sieraczynski-lab/Soloist-KT88/docs/img/plytka_glosniki.png

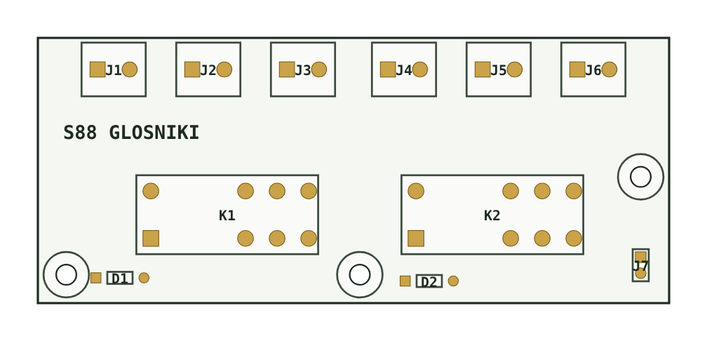
docs/img/plytka_glosniki.png
