sieraczynski-lab/Soloist-KT88/docs/img/plytka_sterowanie.png

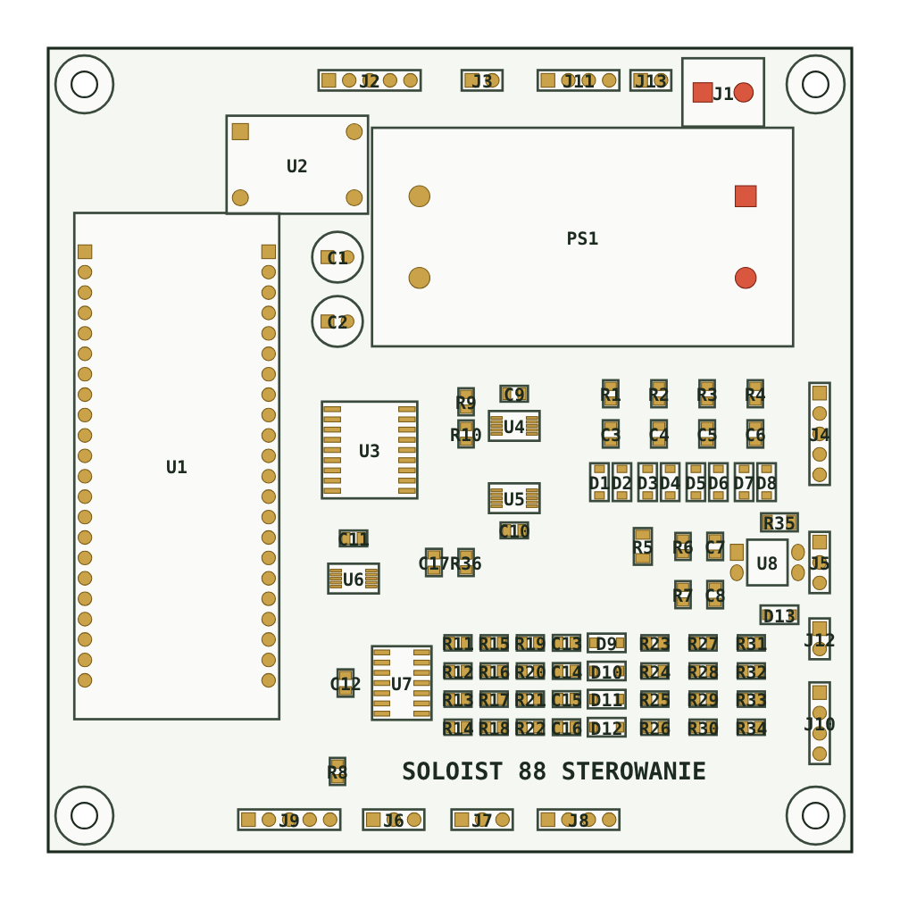
docs/img/plytka_sterowanie.png
