sieraczynski-lab/Soloist-KT88/docs/img/plytka_ul.png

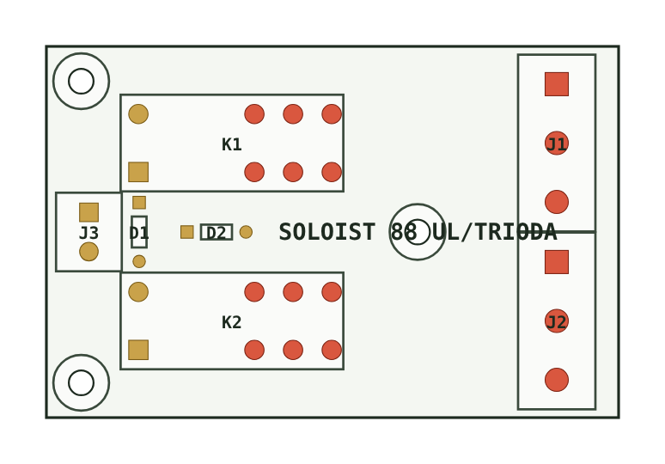
docs/img/plytka_ul.png
