sieraczynski-lab/Soloist-KT88/docs/img/plytka_zasilacz_hv.png

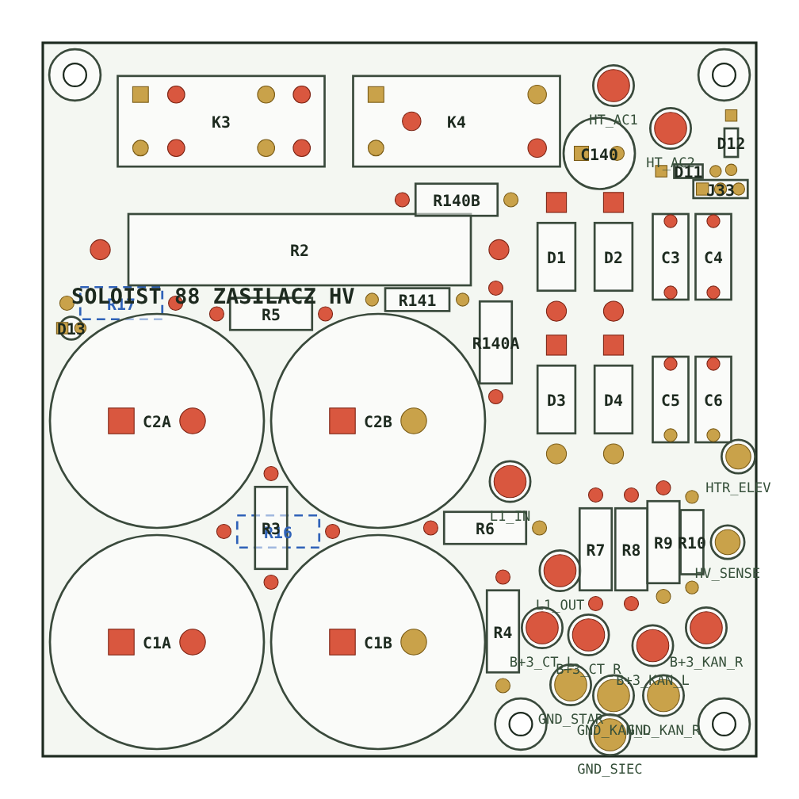
docs/img/plytka_zasilacz_hv.png
