sieraczynski-lab/Soloist-KT88/docs/img/plytka_zasilacz_siec.png

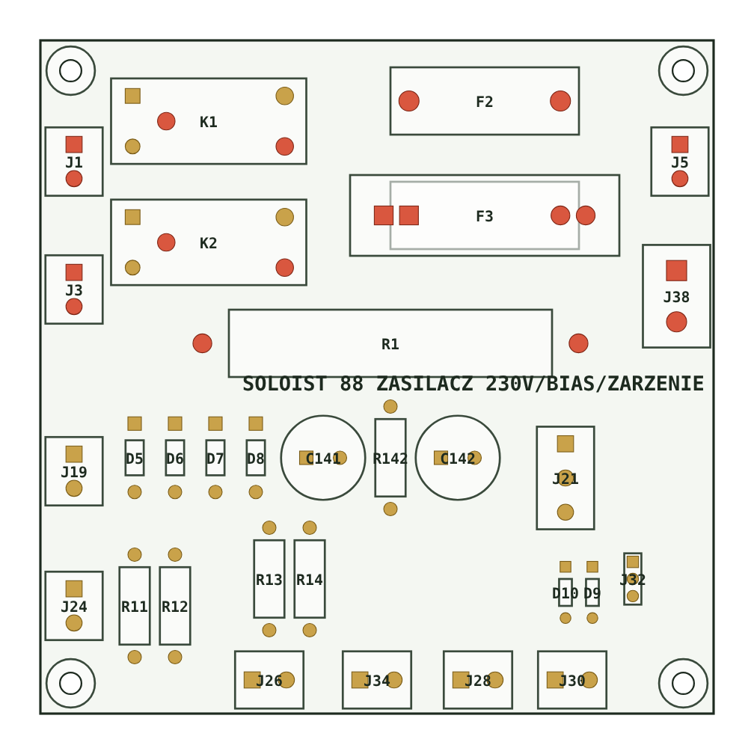
docs/img/plytka_zasilacz_siec.png
