sieraczynski-lab/Soloist-KT88/docs/img/selektor_schemat.png

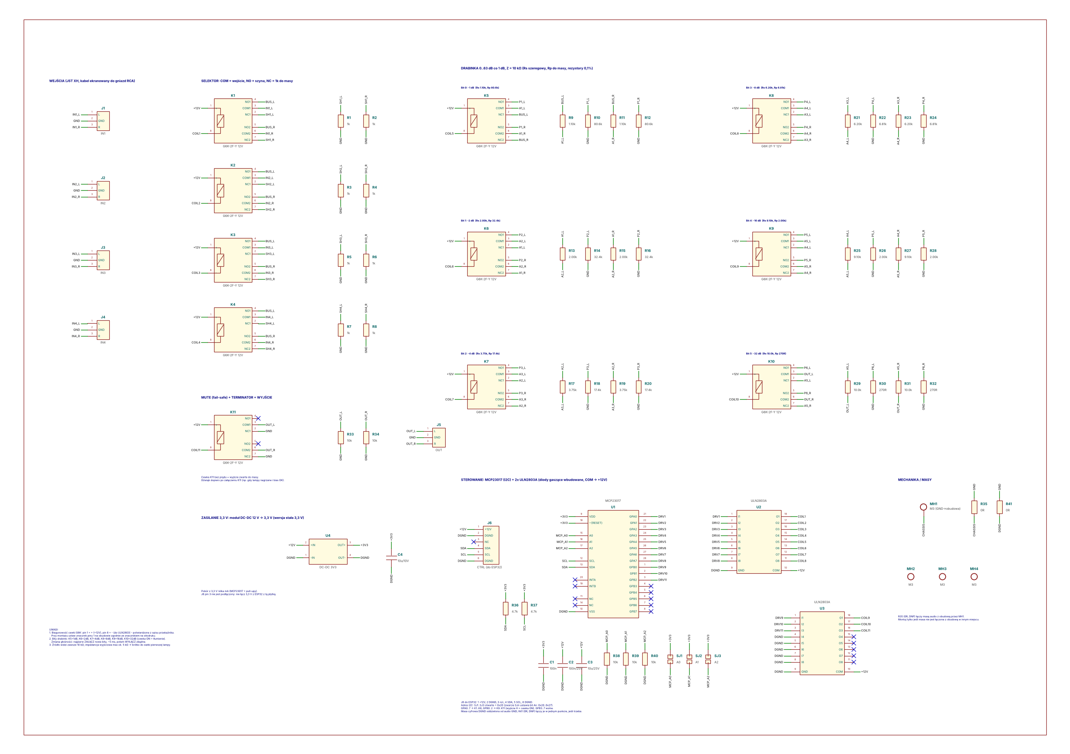
docs/img/selektor_schemat.png
