sieraczynski-lab/Soloist-KT88/docs/img/widok_czesci.png

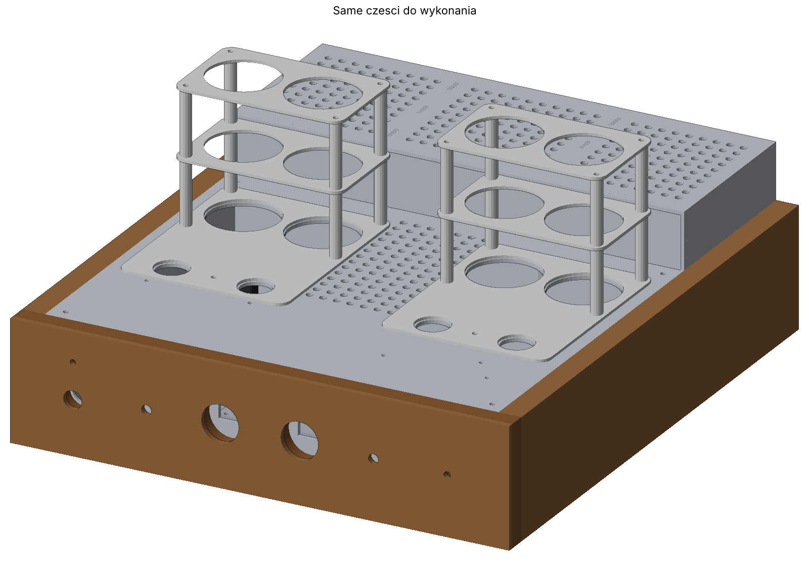
docs/img/widok_czesci.png
