sieraczynski-lab/Soloist-KT88/docs/img/widok_trafo.png

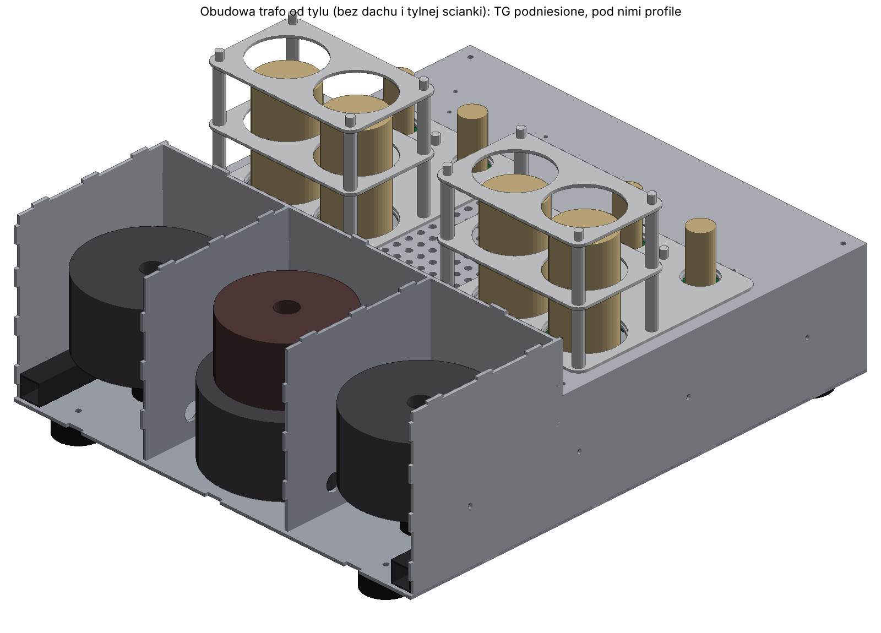
docs/img/widok_trafo.png
