sieraczynski-lab/Soloist-KT88/hardware/pcb/3_pakiet_awaryjny/zasilacz_hv_rozmieszczenie.png

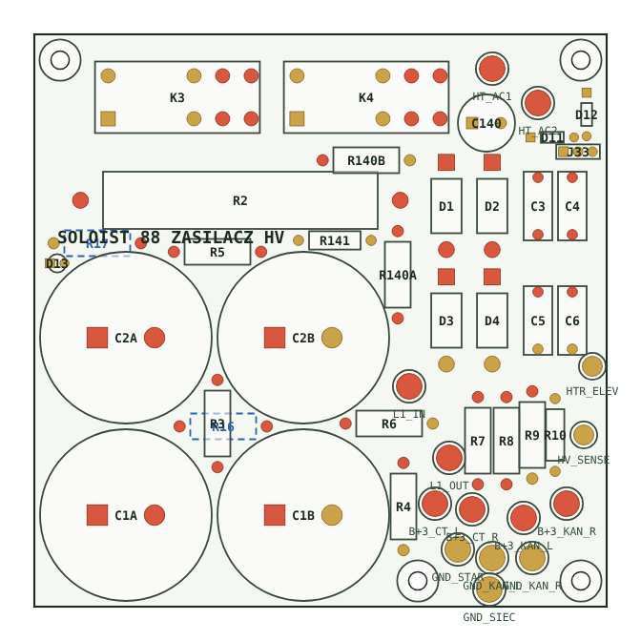
hardware/pcb/3_pakiet_awaryjny/zasilacz_hv_rozmieszczenie.png
