sieraczynski-lab/Soloist-KT88/hardware/selektor/kicad/BOM.csv

Ilość | Referencje | Wartość | Tolerancja | Obudowa | LCSC | Uwagi
1 | C1 | 100n |  | C_0805_2012Metric | C49678 | X7R
1 | C2 | 100n/25V |  | C_0805_2012Metric | C49678 | X7R
1 | C3 | 10u/25V |  | C_1206_3216Metric | C13585 | X5R/X7R
1 | C4 | 10u/10V |  | C_1206_3216Metric | C13585 | X5R/X7R
5 | J1, J2, J3, J4, J5 | JST_XH_B3B-XH-A_1x03_P2.50mm_Vertical |  | JST_XH_B3B-XH-A_1x03_P2.50mm_Vertical |  | JST B3B-XH-A + wtyk XHP-3 (IN1..IN4, OUT)
1 | J6 | CTRL (do ESP32) |  | JST_XH_B6B-XH-A_1x06_P2.50mm_Vertical |  | JST B6B-XH-A + wtyk XHP-6
11 | K1, K2, K3, K4, K5, K6, K7, K8, K9, K10, K11 | G6K-2F-Y 12V |  | Relay_DPDT_Omron_G6K-2F-Y | C397192 | G6K-2F-Y-TR DC12
8 | R1, R2, R3, R4, R5, R6, R7, R8 | 1k | 1% | R_0805_2012Metric | C17513 | 0805W8F1001T5E
2 | R9, R11 | 1.10k | 0.1% | R_0805_2012Metric | C473284 | ERA6AEB112V
2 | R10, R12 | 80.6k | 0.1% | R_0805_2012Metric | C728657 | RT0805BRD0780K6L
4 | R13, R15, R26, R28 | 2.00k | 0.1% | R_0805_2012Metric | C479096 | PTFR0805B2K00P9
2 | R14, R16 | 32.4k | 0.1% | R_0805_2012Metric | C149970 | TR0805B32K4P0550Z
2 | R17, R19 | 3.75k | 0.1% | R_0805_2012Metric | C374641 | AR05BTB3751A010
2 | R18, R20 | 17.4k | 0.1% | R_0805_2012Metric | C47115938 | PTFR0805B17K4P9
2 | R21, R23 | 6.20k | 0.1% | R_0805_2012Metric | C326695 | RT0805BRD076K2L
2 | R22, R24 | 6.81k | 0.1% | R_0805_2012Metric | C728655 | RT0805BRD076K81L
2 | R25, R27 | 9.10k | 0.1% | R_0805_2012Metric | C21571502 | TC0525B9101T5G
2 | R29, R31 | 10.0k | 0.1% | R_0805_2012Metric | C110775 | RT0805BRD0710KL
2 | R30, R32 | 270R | 0.1% | R_0805_2012Metric | C351587 | PTFR0805B270RN9
2 | R33, R34 | 10k | 0.1% | R_0805_2012Metric | C110775 | RT0805BRD0710KL
0 | R35, R41 | 0R |  | R_0805_2012Metric |  | NIE MONTOWAĆ (opcja)
2 | R36, R37 | 4.7k | 1% | R_0805_2012Metric | C17673 | 0805W8F4701T5E
3 | R38, R39, R40 | 10k | 1% | R_0805_2012Metric | C17414 | 0805W8F1002T5E
1 | SJ1 | A0 |  | SolderJumper-2_P1.3mm_Open_Pad1.0x1.5mm
1 | SJ2 | A1 |  | SolderJumper-2_P1.3mm_Open_Pad1.0x1.5mm
1 | SJ3 | A2 |  | SolderJumper-2_P1.3mm_Open_Pad1.0x1.5mm
1 | U1 | MCP23017 |  | SOIC-28W_7.5x17.9mm_P1.27mm | C47023 | MCP23017-E/SO
2 | U2, U3 | ULN2803A |  | SOIC-18W_7.5x11.6mm_P1.27mm | C33924 | ULN2803G-S18-R (UTC)
1 | U4 | DC-DC 3V3 |  | DCDC_Mini_4pin_14.17x8.24mm |  | Mini DC-DC step-down 3,3 V (pinout: 1 -IN, 2 +IN, 3 OUT+, 4 OUT-)
