sieraczynski-lab/Soloist-KT88/hardware/pcb/3_pakiet_awaryjny/kanal_BOM.csv

Oznaczenie | Wartosc | Footprint | Strona | X [mm] | Y [mm] | Grupa | LCSC | Uwagi
J101 | IN | WirePad_3.5 | GORA | 3.50 | 50.00 | ZLACZA |  | wejscie sygnalu (ekranowany, oplot do J102)
J102 | GND_IN | WirePad_3.5 | GORA | 3.50 | 57.00 | ZLACZA |  | masa wejscia
J103 | FB | WirePad_3.5 | GORA | 2.50 | 64.00 | ZLACZA |  | sprzezenie zwrotne z wyjscia 4 ohm
J104 | B+3 | WirePad_4.5 | GORA | 96.50 | 52.00 | ZLACZA |  | 465 V z plytki zasilacza HV
J105 | GND | WirePad_4.5 | GORA | 96.50 | 59.00 | ZLACZA |  | masa zasilania - przewod do gwiazdy
J106 | -78V | WirePad_3.5 | GORA | 96.50 | 64.00 | ZLACZA |  | szyna biasu
J107 | G1_V103 | WirePad_3.5 | GORA | 96.50 | 71.00 | ZLACZA |  | do R117 przy podstawce V103
J108 | G1_V104 | WirePad_3.5 | GORA | 97.50 | 76.50 | ZLACZA |  | do R118 przy podstawce V104
J109 | HTR_A | WirePad_3.5 | GORA | 36.00 | 97.00 | ZLACZA |  | zarzenie 6,3 V
J110 | HTR_B | WirePad_3.5 | GORA | 43.00 | 97.00 | ZLACZA |  | zarzenie 6,3 V
C101 | 47n/250V | C_Box_P10_13x5 | DOL | 13.00 | 52.00 | WEJSCIE
R101 | 220k | R_Axial_0.5W_P12.7 | GORA | 12.00 | 62.00 | WEJSCIE
R102 | 1k | R_Axial_0.5W_P12.7 | GORA | 18.00 | 43.00 | WEJSCIE |  | przy podstawce, pin 9
V101 | EF86 | Noval_B9A_PCB | GORA | 13.00 | 30.00 | EF86 |  | montaz antymikrofonowy; pin 2,7 ekran do katody
R103 | 330R | R_Axial_0.5W_P12.7 | GORA | 37.50 | 38.00 | EF86
R104 | 27k* | R_Axial_0.5W_P12.7_V | GORA | 24.00 | 58.00 | EF86 |  | dobor 22-33k
C103 | 120p* | C_Box_P5_7x4 | DOL | 18.00 | 58.00 | EF86 |  | mika/C0G 500V, dobor 68-220p
R105 | 100k 1W | R_Axial_1W_P15.24_V | GORA | 27.00 | 9.50 | EF86
R106 | 470k | R_Axial_0.5W_P12.7_V | GORA | 23.00 | 13.50 | EF86
C102 | 47n/400V | C_Box_P15_18x6_V | DOL | 26.00 | 30.00 | EF86
R107 | 1M5 | R_Axial_0.5W_P12.7_V | GORA | 17.50 | 12.00 | EF86
R128 | 4k7 (opcja) | R_Axial_0.5W_P12.7_V | GORA | 10.00 | 10.00 | EF86 |  | opcja: siec schodkowa
C107 | 33p (opcja) | C_Box_P5_7x4 | DOL | 4.50 | 10.50 | EF86 |  | opcja: siec schodkowa
V102 | E88CC | Noval_B9A_PCB | GORA | 87.00 | 30.00 | LTP E88CC |  | E88CC/6922/6N23P-EV; wariant B: 6N6P
R108 | 1k | R_Axial_0.5W_P12.7 | GORA | 76.00 | 42.00 | LTP E88CC |  | przy podstawce, pin 2
R109 | 1M | R_Axial_0.5W_P12.7_V | GORA | 70.00 | 51.50 | LTP E88CC
R110 | 1k | R_Axial_0.5W_P12.7 | GORA | 86.00 | 46.00 | LTP E88CC |  | przy podstawce, pin 7
C104 | 470n/400V | C_Box_P22.5_26.5x8.5_V | DOL | 10.00 | 78.00 | LTP E88CC
R111 | 27k 5W | R_Axial_5-7W_P35.56 | DOL | 47.00 | 53.50 | LTP E88CC |  | para 1%; pola pod 7W (wariant B 12k)
R112 | 27k 5W | R_Axial_5-7W_P35.56 | DOL | 47.00 | 44.00 | LTP E88CC |  | para 1%; pola pod 7W (wariant B 12k)
R129 | 1M2 (opcja) | R_Axial_0.5W_P12.7 | GORA | 79.00 | 7.00 | LTP E88CC |  | opcja: korekcja fazy
C108 | 2p7 (opcja) | C_Box_P5_7x4 | DOL | 63.50 | 33.00 | LTP E88CC |  | opcja: korekcja fazy
Q101 | DN2540N5 | TO-220_Vertical_SmallHeatsink | DOL | 72.00 | 30.00 | ZRODLO PRADOWE |  | maly radiator nasuwany ok. 20 K/W (6N6P: wiekszy)
R113 | 1k | R_Axial_0.5W_P12.7 | GORA | 71.50 | 13.50 | ZRODLO PRADOWE |  | przy bramce Q101
D105 | 1N4742A 12V | D_DO-41_P10.16 | DOL | 72.00 | 10.00 | ZRODLO PRADOWE |  | katoda do zrodla
P101 | 200R | Trim_3296W | DOL | 66.00 | 6.00 | ZRODLO PRADOWE |  | prad ogona 14 mA
R114 | 100R | R_Axial_0.5W_P12.7 | GORA | 79.00 | 4.00 | ZRODLO PRADOWE
C105 | 0,47u/630V | C_Box_P27.5_31.5x11 | DOL | 47.00 | 64.50 | SPRZEGANIE DO KT88 |  | MKP 630V, obudowa raster 27,5 mm; wiekszy (osiowy) - poza plytka na przewodach
C106 | 0,47u/630V | C_Box_P27.5_31.5x11 | DOL | 47.00 | 77.50 | SPRZEGANIE DO KT88 |  | MKP 630V, obudowa raster 27,5 mm; wiekszy (osiowy) - poza plytka na przewodach
R115 | 100k | R_Axial_0.5W_P12.7 | GORA | 71.00 | 62.00 | BIAS KT88
R116 | 100k | R_Axial_0.5W_P12.7_V | GORA | 70.00 | 80.00 | BIAS KT88
R119 | 27k | R_Axial_0.5W_P12.7 | GORA | 76.00 | 68.00 | BIAS KT88
P102 | 50k | Trim_3296W | DOL | 79.00 | 58.50 | BIAS KT88 |  | wieloobrotowy; przed startem na max
R121 | 27k | R_Axial_0.5W_P12.7_V | GORA | 85.50 | 70.00 | BIAS KT88
R120 | 27k | R_Axial_0.5W_P12.7_V | GORA | 73.50 | 86.00 | BIAS KT88
P103 | 50k | Trim_3296W | DOL | 78.00 | 76.00 | BIAS KT88 |  | wieloobrotowy; przed startem na max
R122 | 27k | R_Axial_0.5W_P12.7_V | GORA | 94.00 | 84.00 | BIAS KT88
R130 | 330R 2W | R_Axial_2W_P20.32_V | DOL | 89.50 | 61.00 | ZASILANIE KANALU
C130 | 220u/550V | CP_SnapIn_D35_P10 | DOL | 47.00 | 19.00 | ZASILANIE KANALU |  | snap-in D35
R131 | 68k 1W | R_Axial_1W_P15.24 | GORA | 21.00 | 48.00 | ZASILANIE KANALU
C131 | 47u/500V | CP_Radial_D18_P7.5 | DOL | 84.00 | 88.00 | ZASILANIE KANALU
TP101 | B+1 | TestPoint_2 | GORA | 29.50 | 56.50 | PUNKTY POMIAROWE
TP102 | B+2 | TestPoint_2 | GORA | 64.00 | 50.00 | PUNKTY POMIAROWE
TP103 | TAIL | TestPoint_2 | GORA | 64.00 | 28.50 | PUNKTY POMIAROWE
TP104 | ANODE_A | TestPoint_2 | GORA | 65.50 | 57.00 | PUNKTY POMIAROWE
TP105 | ANODE_B | TestPoint_2 | GORA | 66.00 | 40.00 | PUNKTY POMIAROWE
TP106 | BIAS_T | TestPoint_2 | GORA | 64.50 | 65.00 | PUNKTY POMIAROWE
TP107 | BIAS_B | TestPoint_2 | GORA | 65.00 | 80.00 | PUNKTY POMIAROWE
TP108 | A_EF | TestPoint_2 | GORA | 20.00 | 2.50 | PUNKTY POMIAROWE
TP109 | K_EF | TestPoint_2 | GORA | 21.00 | 52.00 | PUNKTY POMIAROWE
MH101 | M3 | MountingHole_M3 | GORA | 4.50 | 4.50 | OTWORY
MH102 | M3 | MountingHole_M3 | GORA | 95.50 | 4.50 | OTWORY
MH103 | M3 | MountingHole_M3 | GORA | 4.50 | 95.50 | OTWORY
MH104 | M3 | MountingHole_M3 | GORA | 95.50 | 95.50 | OTWORY
MH105 | M3 | MountingHole_M3 | GORA | 22.00 | 72.00 | OTWORY
