sieraczynski-lab/Soloist-KT88/hardware/pcb/3_pakiet_awaryjny/sterowanie_BOM.csv

Oznaczenie | Wartosc | Footprint | Strona | X [mm] | Y [mm] | Grupa | LCSC | Uwagi
U1 | ESP32-S3-DevKitC-1 | ESP32-S3-DevKitC-1 | GORA | 16.00 | 52.00 | ESP32 |  | na listwach zenskich
J1 | 230V_IN | TerminalBlock_1x02_P5.08 | GORA | 84.00 | 5.50 | ZASILANIE 12 V / 5 V |  | zlacze srubowe 230 V: z zasilacz_siec J3 (za F2)
PS1 | IRM-15-12 | MeanWell_IRM-15_approx | GORA | 66.50 | 23.50 | ZASILANIE 12 V / 5 V |  | Mean Well IRM-15-12, 12 V / 1,25 A
U2 | DC-DC 5V mini | DCDC_5V_mini_14.17x8.24 | GORA | 31.00 | 14.50 | ZASILANIE 12 V / 5 V |  | mini przetwornica step-down, stale 5 V, min. 1 A; 1 -IN, 2 +IN, 3 OUT+, 4 OUT-
C1 | 100u/25V | CP_Radial_D6.3_P2.5 | GORA | 36.00 | 26.00 | ZASILANIE 12 V / 5 V
C2 | 100u/16V | CP_Radial_D6.3_P2.5 | GORA | 36.00 | 34.00 | ZASILANIE 12 V / 5 V
U3 | ULN2803G-S18-R | SOIC-18W_7.5x11.6mm_P1.27mm | GORA | 40.00 | 50.00 | STEROWNIK PRZEKAZNIKOW | C33924 | UTC ULN2803G-S18-R, SOP-18 (7,5 mm) - LCSC C33924
J2 | RELAY | PinHeader_1x05_P2.54_H | GORA | 40.00 | 4.00 | STEROWNIK PRZEKAZNIKOW |  | do plytek zasilacza (piny 1,2,3 -> siec; 1,4,5 -> HV)
J3 | MUTE | PinHeader_1x02_P2.54_H | GORA | 54.00 | 4.00 | STEROWNIK PRZEKAZNIKOW |  | przekaznik MUTE w przedwzmacniaczu
J11 | UL_TRIODA | PinHeader_1x04_P2.54_H | GORA | 66.00 | 4.00 | STEROWNIK PRZEKAZNIKOW |  | 1-2 plytka UL kanalu L, 3-4 kanalu P (J3 na plytce UL)
J13 | GLOSNIKI | PinHeader_1x02_P2.54_H | GORA | 75.00 | 4.00 | STEROWNIK PRZEKAZNIKOW |  | cewki przelacznika glosnikow (plytka glosniki J7)
J12 | TRIGGER | PinHeader_1x02_P2.54 | GORA | 96.00 | 73.50 | WEJSCIE TRIGGER 12 V |  | z gniazda jack 3,5 mm na tylnej sciance (izolowanego od obudowy): 1 koncowka (+12 V), 2 tulejka
R35 | 1k 1206 | R_1206_3216Metric | GORA | 91.00 | 59.00 | WEJSCIE TRIGGER 12 V | C4410 | ok. 10 mA przy 12 V
D13 | 1N4148W | D_SOD-123 | GORA | 91.00 | 70.50 | WEJSCIE TRIGGER 12 V | C81598 | ochrona przed odwrotna polaryzacja
U8 | PC817 | DIP-4_W7.62 | GORA | 89.00 | 64.00 | WEJSCIE TRIGGER 12 V |  | transoptor - masa Marantza oddzielona od masy Lampy
R36 | 10k | R_0805_2012Metric_V | GORA | 52.00 | 64.00 | WEJSCIE TRIGGER 12 V | C17414 | podciaganie; TRIG_IN = 0 gdy trigger aktywny
C17 | 100n | C_0805_2012Metric_V | GORA | 48.00 | 64.00 | WEJSCIE TRIGGER 12 V | C49678 | filtr zaklocen
U4 | ADS1115IDGSR 0x48 | MSOP-10_3x3mm_P0.5mm | GORA | 58.00 | 47.00 | POMIARY ADC | C37593 | ADDR do GND
U5 | ADS1115IDGSR 0x49 | MSOP-10_3x3mm_P0.5mm | GORA | 58.00 | 56.00 | POMIARY ADC | C37593 | ADDR do VDD
C9 | 100n | C_0805_2012Metric | GORA | 58.00 | 43.00 | POMIARY ADC | C49678 | przy U4
C10 | 100n | C_0805_2012Metric | GORA | 58.00 | 60.00 | POMIARY ADC | C49678 | przy U5
R9 | 4k7 | R_0805_2012Metric_V | GORA | 52.00 | 44.00 | POMIARY ADC | C17673 | podciaganie I2C
R10 | 4k7 | R_0805_2012Metric_V | GORA | 52.00 | 48.00 | POMIARY ADC | C17673 | podciaganie I2C
U6 | MCP4728-E/UN | MSOP-10_3x3mm_P0.5mm | GORA | 38.00 | 66.00 | KOREKTA BIASU (DAC) | C108207 | I2C 0x60, Vref = VDD 3,3 V; LDAC do masy
C11 | 100n | C_0805_2012Metric | GORA | 38.00 | 61.00 | KOREKTA BIASU (DAC) | C49678 | przy U6
U7 | LM324DR | SOIC-14_3.9x8.7mm_P1.27mm | GORA | 44.00 | 79.00 | KOREKTA BIASU (DAC) | C7943 | wzmocnienie x3: 0-3,3 V -> 0-9,9 V
C12 | 100n | C_0805_2012Metric_V | GORA | 37.00 | 79.00 | KOREKTA BIASU (DAC) | C49678 | przy U7
R1 | 10k | R_0805_2012Metric_V | GORA | 70.00 | 43.00 | FILTRY WEJSC | C17414
C3 | 1u | C_0805_2012Metric_V | GORA | 70.00 | 48.00 | FILTRY WEJSC | C28323 | X7R 50 V
D1 | 1N4148W | D_SOD-123_V | GORA | 68.60 | 54.00 | FILTRY WEJSC | C81598 | zacisk do masy
D2 | 1N4148W | D_SOD-123_V | GORA | 71.40 | 54.00 | FILTRY WEJSC | C81598 | zacisk do 3V3
R2 | 10k | R_0805_2012Metric_V | GORA | 76.00 | 43.00 | FILTRY WEJSC | C17414
C4 | 1u | C_0805_2012Metric_V | GORA | 76.00 | 48.00 | FILTRY WEJSC | C28323 | X7R 50 V
D3 | 1N4148W | D_SOD-123_V | GORA | 74.60 | 54.00 | FILTRY WEJSC | C81598 | zacisk do masy
D4 | 1N4148W | D_SOD-123_V | GORA | 77.40 | 54.00 | FILTRY WEJSC | C81598 | zacisk do 3V3
R3 | 10k | R_0805_2012Metric_V | GORA | 82.00 | 43.00 | FILTRY WEJSC | C17414
C5 | 1u | C_0805_2012Metric_V | GORA | 82.00 | 48.00 | FILTRY WEJSC | C28323 | X7R 50 V
D5 | 1N4148W | D_SOD-123_V | GORA | 80.60 | 54.00 | FILTRY WEJSC | C81598 | zacisk do masy
D6 | 1N4148W | D_SOD-123_V | GORA | 83.40 | 54.00 | FILTRY WEJSC | C81598 | zacisk do 3V3
R4 | 10k | R_0805_2012Metric_V | GORA | 88.00 | 43.00 | FILTRY WEJSC | C17414
C6 | 1u | C_0805_2012Metric_V | GORA | 88.00 | 48.00 | FILTRY WEJSC | C28323 | X7R 50 V
D7 | 1N4148W | D_SOD-123_V | GORA | 86.60 | 54.00 | FILTRY WEJSC | C81598 | zacisk do masy
D8 | 1N4148W | D_SOD-123_V | GORA | 89.40 | 54.00 | FILTRY WEJSC | C81598 | zacisk do 3V3
R11 | 10k | R_0805_2012Metric | GORA | 51.00 | 74.00 | KOREKTA BIASU (DAC) | C17414 | wzmocnienie
R15 | 20k | R_0805_2012Metric | GORA | 55.50 | 74.00 | KOREKTA BIASU (DAC) | C4328 | wzmocnienie
R19 | 10k | R_0805_2012Metric | GORA | 60.00 | 74.00 | KOREKTA BIASU (DAC) | C17414 | filtr RC przed LM324 (10k / 1u = 10 ms)
C13 | 1u | C_0805_2012Metric | GORA | 64.50 | 74.00 | KOREKTA BIASU (DAC) | C28323 | filtr RC
D9 | 1N4148W | D_SOD-123 | GORA | 69.50 | 74.00 | KOREKTA BIASU (DAC) | C81598 | zacisk wyjscia LM324: bez 12 V nie schodzi ponizej masy
R23 | 68k | R_0805_2012Metric | GORA | 75.50 | 74.00 | KOREKTA BIASU (DAC) | C17801 | przesuwnik poziomu (0-9,9 V -> ok. -54...-51 V)
R27 | 33k | R_0805_2012Metric | GORA | 81.50 | 74.00 | KOREKTA BIASU (DAC) | C17633 | przesuwnik poziomu, do szyny biasu
R31 | 1k | R_0805_2012Metric | GORA | 87.50 | 74.00 | KOREKTA BIASU (DAC) | C17513 | wyjscie do wezla biasu (ochrona przy zwarciu przewodu)
R12 | 10k | R_0805_2012Metric | GORA | 51.00 | 77.50 | KOREKTA BIASU (DAC) | C17414 | wzmocnienie
R16 | 20k | R_0805_2012Metric | GORA | 55.50 | 77.50 | KOREKTA BIASU (DAC) | C4328 | wzmocnienie
R20 | 10k | R_0805_2012Metric | GORA | 60.00 | 77.50 | KOREKTA BIASU (DAC) | C17414 | filtr RC przed LM324 (10k / 1u = 10 ms)
C14 | 1u | C_0805_2012Metric | GORA | 64.50 | 77.50 | KOREKTA BIASU (DAC) | C28323 | filtr RC
D10 | 1N4148W | D_SOD-123 | GORA | 69.50 | 77.50 | KOREKTA BIASU (DAC) | C81598 | zacisk wyjscia LM324: bez 12 V nie schodzi ponizej masy
R24 | 68k | R_0805_2012Metric | GORA | 75.50 | 77.50 | KOREKTA BIASU (DAC) | C17801 | przesuwnik poziomu (0-9,9 V -> ok. -54...-51 V)
R28 | 33k | R_0805_2012Metric | GORA | 81.50 | 77.50 | KOREKTA BIASU (DAC) | C17633 | przesuwnik poziomu, do szyny biasu
R32 | 1k | R_0805_2012Metric | GORA | 87.50 | 77.50 | KOREKTA BIASU (DAC) | C17513 | wyjscie do wezla biasu (ochrona przy zwarciu przewodu)
R13 | 10k | R_0805_2012Metric | GORA | 51.00 | 81.00 | KOREKTA BIASU (DAC) | C17414 | wzmocnienie
R17 | 20k | R_0805_2012Metric | GORA | 55.50 | 81.00 | KOREKTA BIASU (DAC) | C4328 | wzmocnienie
R21 | 10k | R_0805_2012Metric | GORA | 60.00 | 81.00 | KOREKTA BIASU (DAC) | C17414 | filtr RC przed LM324 (10k / 1u = 10 ms)
C15 | 1u | C_0805_2012Metric | GORA | 64.50 | 81.00 | KOREKTA BIASU (DAC) | C28323 | filtr RC
D11 | 1N4148W | D_SOD-123 | GORA | 69.50 | 81.00 | KOREKTA BIASU (DAC) | C81598 | zacisk wyjscia LM324: bez 12 V nie schodzi ponizej masy
R25 | 68k | R_0805_2012Metric | GORA | 75.50 | 81.00 | KOREKTA BIASU (DAC) | C17801 | przesuwnik poziomu (0-9,9 V -> ok. -54...-51 V)
R29 | 33k | R_0805_2012Metric | GORA | 81.50 | 81.00 | KOREKTA BIASU (DAC) | C17633 | przesuwnik poziomu, do szyny biasu
R33 | 1k | R_0805_2012Metric | GORA | 87.50 | 81.00 | KOREKTA BIASU (DAC) | C17513 | wyjscie do wezla biasu (ochrona przy zwarciu przewodu)
R14 | 10k | R_0805_2012Metric | GORA | 51.00 | 84.50 | KOREKTA BIASU (DAC) | C17414 | wzmocnienie
R18 | 20k | R_0805_2012Metric | GORA | 55.50 | 84.50 | KOREKTA BIASU (DAC) | C4328 | wzmocnienie
R22 | 10k | R_0805_2012Metric | GORA | 60.00 | 84.50 | KOREKTA BIASU (DAC) | C17414 | filtr RC przed LM324 (10k / 1u = 10 ms)
C16 | 1u | C_0805_2012Metric | GORA | 64.50 | 84.50 | KOREKTA BIASU (DAC) | C28323 | filtr RC
D12 | 1N4148W | D_SOD-123 | GORA | 69.50 | 84.50 | KOREKTA BIASU (DAC) | C81598 | zacisk wyjscia LM324: bez 12 V nie schodzi ponizej masy
R26 | 68k | R_0805_2012Metric | GORA | 75.50 | 84.50 | KOREKTA BIASU (DAC) | C17801 | przesuwnik poziomu (0-9,9 V -> ok. -54...-51 V)
R30 | 33k | R_0805_2012Metric | GORA | 81.50 | 84.50 | KOREKTA BIASU (DAC) | C17633 | przesuwnik poziomu, do szyny biasu
R34 | 1k | R_0805_2012Metric | GORA | 87.50 | 84.50 | KOREKTA BIASU (DAC) | C17513 | wyjscie do wezla biasu (ochrona przy zwarciu przewodu)
R5 | 330k 1206 | R_1206_3216Metric_V | GORA | 74.00 | 62.00 | FILTRY WEJSC | C17929 | pomiar -78 V
R6 | 10k | R_0805_2012Metric_V | GORA | 79.00 | 62.00 | FILTRY WEJSC | C17414 | przesuniecie do 3V3
C7 | 1u | C_0805_2012Metric_V | GORA | 83.00 | 62.00 | FILTRY WEJSC | C28323
R7 | 10k | R_0805_2012Metric_V | GORA | 79.00 | 68.00 | FILTRY WEJSC | C17414
C8 | 1u | C_0805_2012Metric_V | GORA | 83.00 | 68.00 | FILTRY WEJSC | C28323
R8 | 4k7 | R_0805_2012Metric_V | GORA | 36.00 | 90.00 | ESP32 | C17673 | pull-up DS18B20
J4 | IK | PinHeader_1x05_P2.54 | GORA | 96.00 | 48.00 | ZLACZA |  | z rezystorow 10R przy KT88
J5 | SENSE | PinHeader_1x03_P2.54 | GORA | 96.00 | 64.00 | ZLACZA
J10 | BIAS_KOR | PinHeader_1x04_P2.54 | GORA | 96.00 | 84.00 | ZLACZA |  | korekta biasu: 1 -> TP106 kanal L, 2 -> TP107 kanal L, 3 -> TP206 kanal P, 4 -> TP207 kanal P; przewody skrecone z masa
J6 | DS18B20 | PinHeader_1x03_P2.54_H | GORA | 43.00 | 96.00 | ZLACZA
J7 | IR | PinHeader_1x03_P2.54_H | GORA | 54.00 | 96.00 | ZLACZA |  | TSOP38238
J8 | WYSWIETLACZ | PinHeader_1x04_P2.54_H | GORA | 66.00 | 96.00 | ZLACZA |  | I2C
J9 | ENKODER | PinHeader_1x05_P2.54_H | GORA | 30.00 | 96.00 | ZLACZA
MH1 | M3 | MountingHole_M3 | GORA | 4.50 | 4.50 | OTWORY
MH2 | M3 | MountingHole_M3 | GORA | 95.50 | 4.50 | OTWORY
MH3 | M3 | MountingHole_M3 | GORA | 4.50 | 95.50 | OTWORY
MH4 | M3 | MountingHole_M3 | GORA | 95.50 | 95.50 | OTWORY
