sieraczynski-lab/Soloist-KT88/hardware/pcb/3_pakiet_awaryjny/zasilacz_hv_BOM.csv

Oznaczenie | Wartosc | Footprint | Strona | X [mm] | Y [mm] | Grupa | LCSC | Uwagi
J7 | HT_AC1 | WirePad_4.5 | GORA | 80.00 | 6.00 | ANODY - PROSTOWNIK |  | S1 360 V przez F3 (plytka sieciowa J38 pin 2)
J8 | HT_AC2 | WirePad_4.5 | GORA | 88.00 | 12.00 | ANODY - PROSTOWNIK |  | S1 360 V
K3 | G2RL-2-DC12 | Relay_DPDT_Omron_G2RL | GORA | 25.00 | 11.00 | ANODY - PROSTOWNIK | C61458 | Omron G2RL-2, dwa styki szeregowo (360 V AC)
K4 | G2RL-2-DC12 | Relay_DPDT_Omron_G2RL | GORA | 58.00 | 11.00 | ANODY - PROSTOWNIK | C61458 | bocznik R_IN; Omron G2RL-2, 2 styki rownolegle
R2 | 100R 10W | R_Cement_10W_P55.88 | GORA | 36.00 | 29.00 | ANODY - PROSTOWNIK |  | R_IN: 100R (bylo 47R) - udar ladowania C1 ok. 5 A zamiast 11 A przez styki K3
D1 | UF5408 | D_DO-201_P15.24_V | GORA | 72.00 | 30.00 | ANODY - PROSTOWNIK
D2 | UF5408 | D_DO-201_P15.24_V | GORA | 80.00 | 30.00 | ANODY - PROSTOWNIK
D3 | UF5408 | D_DO-201_P15.24_V | GORA | 72.00 | 50.00 | ANODY - PROSTOWNIK
D4 | UF5408 | D_DO-201_P15.24_V | GORA | 80.00 | 50.00 | ANODY - PROSTOWNIK
C3 | 10n/1kV | C_Disc_1kV_P10_V | GORA | 88.00 | 30.00 | ANODY - PROSTOWNIK |  | snubber D1
C4 | 10n/1kV | C_Disc_1kV_P10_V | GORA | 94.00 | 30.00 | ANODY - PROSTOWNIK |  | snubber D2
C5 | 10n/1kV | C_Disc_1kV_P10_V | GORA | 88.00 | 50.00 | ANODY - PROSTOWNIK |  | snubber D3
C6 | 10n/1kV | C_Disc_1kV_P10_V | GORA | 94.00 | 50.00 | ANODY - PROSTOWNIK |  | snubber D4
C1A | 470u/400V | CP_SnapIn_D30_P10 | GORA | 16.00 | 84.00 | FILTR B+3 |  | snap-in 30x50
C1B | 470u/400V | CP_SnapIn_D30_P10 | GORA | 47.00 | 84.00 | FILTR B+3 |  | snap-in 30x50
R3 | 150k 1W | R_Axial_1W_P15.24_V | GORA | 32.00 | 68.00 | FILTR B+3 |  | balans + rozladowanie (150k: 0,43 W przy 255 V)
R4 | 150k 1W | R_Axial_1W_P15.24_V | GORA | 64.50 | 82.50 | FILTR B+3
J9 | L1_IN | WirePad_4.5 | GORA | 65.50 | 61.50 | FILTR B+3 |  | do dlawika L1
J10 | L1_OUT | WirePad_4.5 | GORA | 72.50 | 74.00 | FILTR B+3 |  | z dlawika L1
C2A | 470u/400V | CP_SnapIn_D30_P10 | GORA | 16.00 | 53.00 | FILTR B+3 |  | snap-in 30x50
C2B | 470u/400V | CP_SnapIn_D30_P10 | GORA | 47.00 | 53.00 | FILTR B+3 |  | snap-in 30x50
R5 | 150k 1W | R_Axial_1W_P15.24 | GORA | 32.00 | 38.00 | FILTR B+3
R6 | 150k 1W | R_Axial_1W_P15.24 | GORA | 62.00 | 68.00 | FILTR B+3
R7 | 1M 1600V | R_Axial_1W_P15.24_V | GORA | 77.50 | 71.00 | POMIAR B+ |  | pomiar B+ (opcja)
R8 | 1M 1600V | R_Axial_1W_P15.24_V | GORA | 82.50 | 71.00 | POMIAR B+
R9 | 1M 1600V | R_Axial_1W_P15.24_V | GORA | 87.00 | 70.00 | POMIAR B+
R10 | 15k | R_Axial_0.5W_P12.7_V | GORA | 91.00 | 70.00 | POMIAR B+
J18 | HV_SENSE | WirePad_3.5 | GORA | 96.00 | 70.00 | POMIAR B+ |  | do sterowania
J11 | B+3_CT_L | WirePad_4.5 | GORA | 70.00 | 82.00 | ZLACZA |  | srodek T101
J12 | B+3_CT_R | WirePad_4.5 | GORA | 76.50 | 83.00 | ZLACZA |  | srodek T201
J13 | B+3_KAN_L | WirePad_4.5 | GORA | 85.50 | 84.50 | ZLACZA
J14 | B+3_KAN_R | WirePad_4.5 | GORA | 93.00 | 82.00 | ZLACZA
J15 | GND_STAR | WirePad_4.5 | GORA | 74.00 | 90.00 | ZLACZA |  | punkt gwiazdy masy
J16 | GND_KAN_L | WirePad_4.5 | GORA | 80.00 | 91.50 | ZLACZA
J17 | GND_KAN_R | WirePad_4.5 | GORA | 87.00 | 91.50 | ZLACZA
J37 | GND_SIEC | WirePad_4.5 | GORA | 79.50 | 97.00 | ZLACZA |  | masa plytki sieciowej
R140A | 150k 1W | R_Axial_1W_P15.24_V | GORA | 63.50 | 42.00 | ELEWACJA ZARZENIA |  | elewacja +42 V z B+3; 2x150k szeregowo - po ok. 212 V na rezystor
R140B | 150k 1W | R_Axial_1W_P15.24 | GORA | 58.00 | 22.00 | ELEWACJA ZARZENIA |  | elewacja, druga polowa
R141 | 30k | R_Axial_0.5W_P12.7 | GORA | 52.50 | 36.00 | ELEWACJA ZARZENIA
C140 | 47u/100V | CP_Radial_D10_P5 | GORA | 79.00 | 15.50 | ELEWACJA ZARZENIA
J36 | HTR_ELEV | WirePad_3.5 | GORA | 97.50 | 58.00 | ELEWACJA ZARZENIA |  | do plytki sieciowej (J34 pin 1)
J33 | RELAY_B | PinHeader_1x03_P2.54_H | GORA | 95.00 | 20.50 | CEWKI K3/K4 |  | z plytki sterowania (J2 piny 1,4,5)
D11 | 1N4148 | D_DO-35_P7.62 | GORA | 90.50 | 18.00 | CEWKI K3/K4
D12 | 1N4148 | D_DO-35_P7.62_V | GORA | 96.50 | 14.00 | CEWKI K3/K4
R16 | 220k 1W | R_Axial_1W_P15.24 | DOL | 33.00 | 68.50 | LED HV |  | LED HV, ok. 1 mA
R17 | 220k 1W | R_Axial_1W_P15.24 | DOL | 11.00 | 36.50 | LED HV
D13 | LED HV czerwona | LED_D3.0_P2.54 | GORA | 4.00 | 40.00 | LED HV |  | swieci, dopoki B+ > ok. 30-50 V; dioda wysokiej sprawnosci 2 mA
MH1 | M3 | MountingHole_M3 | GORA | 4.50 | 4.50 | OTWORY
MH2 | M3 | MountingHole_M3 | GORA | 95.50 | 4.50 | OTWORY
MH3 | M3 | MountingHole_M3 | GORA | 67.00 | 95.50 | OTWORY
MH4 | M3 | MountingHole_M3 | GORA | 95.50 | 95.50 | OTWORY
