sieraczynski-lab/Soloist-KT88/hardware/pcb/5_BOM_czesci_LCSC/kanal_BOM_LCSC.xlsx

Soloist 88 - BOM plytki kanal (x2) - elementy przewlekane
Czesci wybrane z czesci DOSTEPNYCH na magazynie wg bazy katalogu JLCPCB/LCSC z 25.10.2026 (kolumna Stan). Wiersze na pomaranczowo = brak w LCSC, kup w TME / sklepie lampowym. Minimalne ilosci sprawdz w koszyku.
Lp | Oznaczenia | Ilosc na plytke | Liczba plytek | Ilosc razem | Opis / parametry | Obudowa / raster | Producent | MPN | LCSC | Stan mag. (25.10) | Uwagi / gdzie kupic
1 | C101 | 1 | 2 | 2 | Kondensator polipropylenowy 47 nF 630 V (wejscie) | raster 10 |  | KP473J2J1001 | C390076 | 75656
2 | C102 | 1 | 2 | 2 | Kondensator polipropylenowy 47 nF 630 V | raster 15 |  | MMK473J2JD3KN158G2 | C504240 | 3000
3 | C103 | 1 | 2 | 2 | Kondensator ceramiczny SL 100 pF 1 kV (start dla C103) | raster 5 |  | CC45SL3AD101JYVNA | C342396 | 8123 | 120 pF HV przewlekanego brak; zacznij od 100 pF. Do doboru lepszy mikowy 68-220 pF z TME
4 | C104 | 1 | 2 | 2 | Kondensator polipropylenowy 0,47 uF 630 V | raster 22,5 |  | C322J474J90C000 | C401319 | 1754
5 | C105, C106 | 2 | 2 | 4 | Kondensator polipropylenowy MKP 0,47 uF 630 V (sprzeganie KT88) | raster 27,5 |  | MMKP474J2J2701 | C557511 | 1059 | audiofilsko: WIMA MKP4 / Mundorf z TME lub osiowy poza plytka
6 | C107 | 1 | 2 | 2 | Kondensator ceramiczny SL 33 pF 1 kV (opcja) | raster 5 |  | N06S1B330KQ0T0S0N0 | C366798 | 2006
7 | C108 | 1 | 2 | 2 | Kondensator 2,7 pF 500 V (opcja) | raster 5 |  |  |  |  | brak w LCSC - tylko jesli potrzebna korekcja fazy (TME)
8 | C130 | 1 | 2 | 2 | Kondensator elektrolityczny 220 uF 550 V snap-in | D35 x 50, raster 10 mm |  | TLS550V220M35*50 | C347031 | 17 | malo na stanie (17 szt.) - zamow od razu; alternatywa TME: Kemet ALC70A221DC550
9 | C131 | 1 | 2 | 2 | Kondensator elektrolityczny 47 uF 500 V 105 C | radialny D18 x 32, raster 7,5 |  | ECH2HM470M32OTZO | C882083 | 923
10 | D105 | 1 | 2 | 2 | Dioda Zenera 12 V 1 W | DO-41 |  | 1N4742A | C140853 | 5203
11 | P101 | 1 | 2 | 2 | Potencjometr wieloobrotowy 200 Ohm | Bourns 3296W |  | 3296W-1-201LF | C83685 | 2673
12 | P102, P103 | 2 | 2 | 4 | Potencjometr wieloobrotowy 50 kOhm | Bourns 3296W |  | 3296W-1-503LF | C83686 | 6935
13 | Q101 | 1 | 2 | 2 | MOSFET z kanalem zubozanym 400 V, TO-220 | TO-220 |  | DN2540N5-G |  |  | BRAK W LCSC (jest tylko TO-92 / SOT-89 - za male na 1,2 W) - TME / Mouser
14 | R101 | 1 | 2 | 2 | Rezystor 220 kOhm 0,25 W 1% (wejscie) | osiowy, raster 12,7 mm |  | MFR-25FTE52-220K | C172984 | 26524
15 | R102, R108, R110, R113 | 4 | 2 | 8 | Rezystor 1 kOhm 0,5 W 1% 300 V | osiowy, raster 12,7 mm |  | MF1/2W-1KΩ±1% T | C119418 | 5850
16 | R103 | 1 | 2 | 2 | Rezystor 330 Ohm 0,5 W 1% | osiowy, raster 12,7 mm |  | MFR0S2F3300A20 | C58577 | 29623
17 | R104 | 1 | 2 | 2 | Rezystor 27 kOhm 0,25 W 1% (R104, NFB) | osiowy, raster 12,7 mm |  | MFR-25FTE52-27K | C172994 | 2906 | wartosc startowa; do doboru dokup 22k, 24k, 30k, 33k (seria MFR-25FTE52)
18 | R105 | 1 | 2 | 2 | Rezystor 100 kOhm 1 W 1% 350 V | osiowy, raster 15,24 mm |  | MFR01SF1003A10 | C85019 | 3514
19 | R106 | 1 | 2 | 2 | Rezystor 470 kOhm 0,5 W 1% 300 V (ok. 220 V na rezystorze) | osiowy, raster 12,7 mm |  | MF1/2W-470KΩ±1% T | C119452 | 3946
20 | R107 | 1 | 2 | 2 | Rezystor 1,5 MOhm 0,25 W 1% 250 V (73 V na rezystorze) | osiowy, raster 12,7 mm |  | MFR0W4F1504A50 | C122938 | 4950
21 | R109 | 1 | 2 | 2 | Rezystor 1 MOhm 0,5 W 1% 300 V | osiowy, raster 12,7 mm |  | RN 1/2WS 1M F T/B A1 | C433529 | 4971
22 | R111, R112 | 2 | 2 | 4 | Rezystor 27 kOhm 5 W 1% (anody LTP, para) | osiowy, raster 35,56 mm, korpus do 30 x 9 |  |  |  |  | BRAK W LCSC - TME (np. rezystor metalizowany 5 W 1%); pola zmieszcza tez 7 W
23 | R114 | 1 | 2 | 2 | Rezystor 100 Ohm 0,5 W 1% | osiowy, raster 12,7 mm |  | MFR50SFTE52-100R | C173138 | 14983
24 | R115, R116 | 2 | 2 | 4 | Rezystor 100 kOhm 0,5 W 1% 300 V | osiowy, raster 12,7 mm |  | RN 1/2WS 100K F T/B A1 | C433530 | 7262
25 | R119, R120, R121, R122 | 4 | 2 | 8 | Rezystor 27 kOhm 0,25 W 1% (wystarczy: najwyzej 0,03 W) | osiowy, raster 12,7 mm |  | MFR-25FTE52-27K | C172994 | 2906 | 27k 0,5 W 1% nie ma na stanie - 0,25 W wystarcza (siec biasu, max 78 V)
26 | R128 | 1 | 2 | 2 | Rezystor 4,7 kOhm 0,5 W 1% 300 V | osiowy, raster 12,7 mm |  | RN 1/2WS 4K7 F T/B A1 | C433513 | 10358
27 | R129 | 1 | 2 | 2 | Rezystor 1,2 MOhm 0,25 W 1% (opcja) | osiowy, raster 12,7 mm |  | MF0W4FF1204A50 | C20625224 | 868
28 | R130 | 1 | 2 | 2 | Rezystor 330 Ohm 2 W 1% 500 V | osiowy, raster 20,32 mm |  | MFR02SF3300A10 | C58731 | 3295
29 | R131 | 1 | 2 | 2 | Rezystor 68 kOhm 1 W 1% | osiowy, raster 15,24 mm |  | MF01SFF6802A10 | C20625257 | 633
30 | V101 | 1 | 2 | 2 | Podstawka B9A (noval) do druku, ceramiczna | noval PCB |  |  |  |  | BRAK W LCSC - sklep lampowy (np. TubeTown); lampa osobno
31 | V102 | 1 | 2 | 2 | Podstawka B9A (noval) do druku, ceramiczna | noval PCB |  |  |  |  | BRAK W LCSC - sklep lampowy; lampa E88CC / 6922 osobno
