sieraczynski-lab/Soloist-KT88/hardware/pcb/5_BOM_czesci_LCSC/poza_plytkami_BOM.xlsx

Soloist 88 - elementy poza plytkami (przy podstawkach KT88, obudowa) - wybrane, bez transformatorow
Lp | Oznaczenia | Ilosc razem | Opis / parametry | Obudowa | Producent | MPN | LCSC | Stan mag. (25.10) | Uwagi
1 | R117, R118 (x2 kanaly) | 4 | Rezystor 4,7 kOhm 0,5 W 1% - przy podstawce KT88, pin 5 | osiowy |  | RN 1/2WS 4K7 F T/B A1 | C433513 | 10358
2 | R123, R124 (x2) | 4 | Rezystor 270 Ohm 2 W - siatka ekranowa, przy podstawce, pin 4 | osiowy |  | MO2WS-270Ω±5%-6T63 | C479464 | 296 | malo na stanie (ok. 300)
3 | R125, R126 (x2) | 4 | Rezystor 10 Ohm 1 W 1% - katoda KT88 (pomiar pradu) | osiowy |  | MFR01SF100JA10 | C58689 | 2971
4 | D101-D104 (x2) | 8 | Dioda 1N4007 - zabezpieczenie rezystora katodowego | DO-41 |  | 1N4007G | C2457 | 165400
5 | R127 (x2) | 2 | Rezystor 100 Ohm 2 W - obciazenie awaryjne na zaciskach | osiowy |  | MFR02SF1000A10 | C58717 | 74264
6 | V103, V104 (x2) | 4 | Podstawka octal ceramiczna do KT88 (montaz na szpilkach) | octal |  |  |  |  | BRAK W LCSC - sklep lampowy; sprawdz rozstaw otworow (obudowa: 50 mm)
7 | F1 | 1 | Gniazdo IEC C14 z oprawka bezpiecznika (+ ew. wylacznik) |  |  |  |  |  | TME
8 | zaciski glosnikowe | 8 | Zacisk glosnikowy (4 pary: 2 x KOLUMNA, 2 x Z MARANTZA) | panelowy, otwor 9 mm |  |  |  |  | TME / sklep audio; izolowane od obudowy
9 | gniazdo TRIGGER | 1 | Gniazdo jack 3,5 mm MONO panelowe, korpus plastikowy (izolowane od obudowy) | otwor 6 mm |  |  |  |  | TME; tulejka NIE moze dotykac obudowy
10 | kabel TRIGGER | 1 | Kabel jack 3,5 mm mono - jack 3,5 mm mono |  |  |  |  |  | do wyjscia TRIGGER OUT w Marantz SR7013
11 | F1 wkladka | 2 | Bezpiecznik zwloczny T2,5A 5x20 (1 + zapas) | 5x20 |  | 021802.5MXP | C142705 | 930
12 | F2 zapas | 1 | Bezpiecznik zwloczny T500mA 5x20 (zapas) | 5x20 |  | 0218.500MXP | C142727 | 1278
