sieraczynski-lab/Soloist-KT88/hardware/pcb/5_BOM_czesci_LCSC/sterowanie_BOM_LCSC.xlsx

Soloist 88 - BOM plytki sterowanie (x1) - elementy przewlekane (SMD montuje JLCPCB - osobny plik)
Czesci wybrane z czesci DOSTEPNYCH na magazynie wg bazy katalogu JLCPCB/LCSC z 25.10.2026 (kolumna Stan). Wiersze na pomaranczowo = brak w LCSC, kup w TME / sklepie lampowym. Minimalne ilosci sprawdz w koszyku.
Lp | Oznaczenia | Ilosc na plytke | Liczba plytek | Ilosc razem | Opis / parametry | Obudowa / raster | Producent | MPN | LCSC | Stan mag. (25.10) | Uwagi / gdzie kupic
1 | C1, C2 | 2 | 1 | 2 | Kondensator elektrolityczny 100 uF 25 V | radialny D6,3 x 11, raster 2,5 |  | ERS1EM101E11OT | C112509 | 244957
2 | J1 | 1 | 1 | 1 | Zlacze srubowe 2-pin 5,08 mm |  | KEFA | KF128-5.08-2P-AA | C474952 | 62181
3 | PS1 | 1 | 1 | 1 | Zasilacz Mean Well IRM-15-12 (12 V / 1,25 A) | 52,4 x 27,2 x 24 mm |  | IRM-15-12 | C6394169 | 4575
4 | U1 | 1 | 1 | 1 | Modul ESP32-S3-DevKitC-1 (N8R8 lub N16R8) | 2 x 22 piny |  | ESP32-S3-DevKitC-1 |  |  | Botland / Kamami / TME
5 | U1 (2 x 22 piny) | 2 | 1 | 2 | Listwa zenska 1x20 2,54 mm | 2,54 mm | Cancome | B-2200S20P-A120 | C124410 | 455 | 2 szt. (+ 1x2 ponizej = 22 piny na strone)
6 | U1 (2 x 22 piny) | 2 | 1 | 2 | Listwa zenska 1x2 2,54 mm | 2,54 mm | Cancome | B-2200S02P-A120 | C124411 | 1043 | 2 szt.
7 | U2 | 1 | 1 | 1 | Mini przetwornica 12 V -> 5 V, min. 1 A, 4 piny | 14,17 x 8,24 mm |  |  |  |  | Twoj wybrany modul
8 | U8 | 1 | 1 | 1 | Transoptor PC817 (wejscie trigger) | DIP-4 |  | PC817X2NSZ9F | C96006 | 43538
9 | listwy katowe (28 pin) | 1 | 1 | 1 | Listwa kolkowa katowa 1x40, 2,54 mm (do ciecia) | 2,54 mm |  | 2.54-1*40P (katowa) | C74252 | 4624 | potrzeba 28 pinow + wtyki
10 | listwy proste (14 pin) | 1 | 1 | 1 | Listwa kolkowa prosta 1x40, 2,54 mm (do ciecia) | 2,54 mm |  | 2.54-1*40P | C2337 | 73249 | potrzeba 14 pinow + wtyki
