sieraczynski-lab/Soloist-KT88/hardware/pcb/5_BOM_czesci_LCSC/ul_BOM_LCSC.xlsx

Soloist 88 - BOM plytki ul (x2) - elementy przewlekane
Czesci wybrane z czesci DOSTEPNYCH na magazynie wg bazy katalogu JLCPCB/LCSC z 25.10.2026 (kolumna Stan). Wiersze na pomaranczowo = brak w LCSC, kup w TME / sklepie lampowym. Minimalne ilosci sprawdz w koszyku.
Lp | Oznaczenia | Ilosc na plytke | Liczba plytek | Ilosc razem | Opis / parametry | Obudowa / raster | Producent | MPN | LCSC | Stan mag. (25.10) | Uwagi / gdzie kupic
1 | D1, D2 | 2 | 2 | 4 | Dioda 1N4148 | DO-35 |  | 1N4148 | C402212 | 162903
2 | J1, J2 | 2 | 2 | 4 | Zlacze srubowe 3-pin 7,62 mm, 450 V |  | KEFA | KF7.62-3P | C707825 | 4819
3 | J3 | 1 | 2 | 2 | Zlacze srubowe 2-pin 5,08 mm |  | KEFA | KF128-5.08-2P-AA | C474952 | 62181
4 | K1, K2 | 2 | 2 | 4 | Przekaznik Omron G2RL-2 12 V DPDT 8 A | 29 x 12,7 mm |  | G2RL-2-DC12 | C61458 | 1258 | przed zamowieniem plytek sprawdz piny (CZYTAJ_MNIE)
