sieraczynski-lab/Soloist-KT88/hardware/pcb/5_BOM_czesci_LCSC/zasilacz_hv_BOM_LCSC.xlsx

Soloist 88 - BOM plytki zasilacz_hv (x1) - elementy przewlekane
Czesci wybrane z czesci DOSTEPNYCH na magazynie wg bazy katalogu JLCPCB/LCSC z 25.10.2026 (kolumna Stan). Wiersze na pomaranczowo = brak w LCSC, kup w TME / sklepie lampowym. Minimalne ilosci sprawdz w koszyku.
Lp | Oznaczenia | Ilosc na plytke | Liczba plytek | Ilosc razem | Opis / parametry | Obudowa / raster | Producent | MPN | LCSC | Stan mag. (25.10) | Uwagi / gdzie kupic
1 | C1A, C1B, C2A, C2B | 4 | 1 | 4 | Kondensator elektrolityczny 470 uF 450 V snap-in (450 V zamiast 400 V) | D30 x 50, raster 10 mm |  | KN471M45030*50A | C513378 | 969 | 470 uF/400 V w D30 brak na stanie; wysokosc 50 mm - sprawdz z obudowa (krotszy: LSG450M477S353S1AA C47325526, 30 x 35)
2 | C3, C4, C5, C6 | 4 | 1 | 4 | Kondensator polipropylenowy 10 nF 1 kV (snubbery mostka) | raster 10 |  | MMKP103J3A1001 | C484936 | 5509
3 | C140 | 1 | 1 | 1 | Kondensator elektrolityczny 47 uF 100 V | radialny D10 x 13, raster 5 |  | ERS1KM470G13OT | C383038 | 10840
4 | D1, D2, D3, D4 | 4 | 1 | 4 | Dioda szybka UF5408 1000 V 3 A | DO-201AD |  | UF5408 | C424502 | 24211
5 | D11, D12 | 2 | 1 | 2 | Dioda 1N4148 | DO-35 |  | 1N4148 | C402212 | 162903
6 | D13 | 1 | 1 | 1 | LED 3 mm czerwona | 3 mm, raster 2,54 |  | 204-10SURD/S530-A3-L | C99771 | 196665 | swieci juz przy ok. 1 mA
7 | K3, K4 | 2 | 1 | 2 | Przekaznik Omron G2RL-2 12 V DPDT 8 A | 29 x 12,7 mm |  | G2RL-2-DC12 | C61458 | 1258 | przed zamowieniem plytek sprawdz piny (CZYTAJ_MNIE)
8 | R2 | 1 | 1 | 1 | Rezystor drutowy 10 W 100 Ohm (R_IN) | osiowy 9 x 36,5 mm w polach 55,88 mm |  | EWWR0010J100RT9 | C349082 | 818
9 | R3, R4, R5, R6, R140A, R140B | 6 | 1 | 6 | Rezystor 150 kOhm 1 W 1% | osiowy, raster 15,24 mm, korpus 4,5 x 11,5 |  | MF1W-150KΩ±1% T | C119513 | 20037
10 | R7, R8, R9 | 3 | 1 | 3 | Rezystor 1 MOhm 1 W 5%, 4 kV (dzielnik pomiaru B+) | osiowy, raster 15,24 mm |  | RCR60CT52A105J | C782212 | 2369 | Vishay VR37 brak na stanie; ten ma 4 kV - pomiar i tak kalibrujesz w programie
11 | R10 | 1 | 1 | 1 | Rezystor 15 kOhm 0,5 W 1% 350 V | osiowy, raster 12,7 mm |  | MF1/2W-15K±1%-XT52 | C601895 | 2242
12 | R16, R17 | 2 | 1 | 2 | Rezystor 220 kOhm 1 W 1% 350 V | osiowy, raster 15,24 mm |  | MFR01SF2203A10 | C82511 | 5242
13 | R141 | 1 | 1 | 1 | Rezystor 30 kOhm 0,5 W 1% | osiowy, raster 12,7 mm |  | MF1/2WS-30KΩ±1% T | C129921 | 9590
14 | listwy katowe (3 pin) | 1 | 1 | 1 | Listwa kolkowa katowa 1x40, 2,54 mm (do ciecia) | 2,54 mm |  | 2.54-1*40P (katowa) | C74252 | 4624 | potrzeba 3 pinow + wtyki
