sieraczynski-lab/Soloist-KT88/hardware/pcb/5_BOM_czesci_LCSC/zasilacz_siec_BOM_LCSC.xlsx

Soloist 88 - BOM plytki zasilacz_siec (x1) - elementy przewlekane
Czesci wybrane z czesci DOSTEPNYCH na magazynie wg bazy katalogu JLCPCB/LCSC z 25.10.2026 (kolumna Stan). Wiersze na pomaranczowo = brak w LCSC, kup w TME / sklepie lampowym. Minimalne ilosci sprawdz w koszyku.
Lp | Oznaczenia | Ilosc na plytke | Liczba plytek | Ilosc razem | Opis / parametry | Obudowa / raster | Producent | MPN | LCSC | Stan mag. (25.10) | Uwagi / gdzie kupic
1 | C141, C142 | 2 | 1 | 2 | Kondensator elektrolityczny 100 uF 160 V | radialny D12,5 x 20, raster 5 |  | EGW2CM101W20OT | C106374 | 62749
2 | D5, D6, D7, D8 | 4 | 1 | 4 | Dioda 1N4007 1000 V 1 A | DO-41 |  | 1N4007G | C2457 | 165400
3 | D9, D10 | 2 | 1 | 2 | Dioda 1N4148 | DO-35 |  | 1N4148 | C402212 | 162903
4 | F2 | 1 | 1 | 1 | Oprawka bezpiecznika 5x20 do druku, zamknieta (PTF-77) + bezpiecznik T500mA 5x20 | raster 22,5 mm |  | PTF-77 + 0218.500MXP | C717030 + C142727 | 104441 + 1278 | dwie pozycje do koszyka: oprawka i bezpiecznik zwloczny
5 | F3 | 1 | 1 | 1 | Oprawka 5x20 lub 6,3x32 do druku min. 400 V AC + bezpiecznik T1A min. 400 V AC | raster 22,5 (5x20) / 30 (6,3x32) |  |  |  |  | BRAK W LCSC (oprawki i bezpieczniki maja 250 V) - TME: ceramiczny zwloczny 500 V AC i oprawka na to napiecie
6 | J1, J3, J5, J19, J24, J26, J28, J30, J34 | 9 | 1 | 9 | Zlacze srubowe 2-pin 5,08 mm |  | KEFA | KF128-5.08-2P-AA | C474952 | 62181
7 | J21 | 1 | 1 | 1 | Zlacze srubowe 3-pin 5,08 mm |  | KEFA | KF128-5.08-3P-AA | C474953 | 9043
8 | J38 | 1 | 1 | 1 | Zlacze srubowe 2-pin 7,62 mm, 450 V |  | KEFA | KF7.62-2P | C707824 | 25094
9 | K1, K2 | 2 | 1 | 2 | Przekaznik Omron G2RL-2 12 V DPDT 8 A | 29 x 12,7 mm |  | G2RL-2-DC12 | C61458 | 1258 | przed zamowieniem plytek sprawdz piny (CZYTAJ_MNIE)
10 | R1 | 1 | 1 | 1 | Rezystor drutowy 10 W 47 Ohm (R_SS) | osiowy 9 x 36,5 mm w polach 55,88 mm |  | EWWR0010J47R0T9 | C349125 | 25 | malo na stanie (25 szt.) - zamow od razu; alternatywa: cementowy SQP 10 W z TME
11 | R11, R12, R13, R14 | 4 | 1 | 4 | Rezystor 100 Ohm 1 W 1% 350 V | osiowy, raster 15,24 mm |  | MF1W-100Ω±1% T | C119469 | 12034
12 | R142 | 1 | 1 | 1 | Rezystor 1 kOhm 1 W 1% | osiowy, raster 15,24 mm |  | MFR1WSFTE52-1K | C172926 | 7896
13 | listwy proste (3 pin) | 1 | 1 | 1 | Listwa kolkowa prosta 1x40, 2,54 mm (do ciecia) | 2,54 mm |  | 2.54-1*40P | C2337 | 73249 | potrzeba 3 pinow + wtyki
