sieraczynski-lab/Soloist-KT88/hardware/case/DXF/DREWNO_front_rama_15mm.dxf

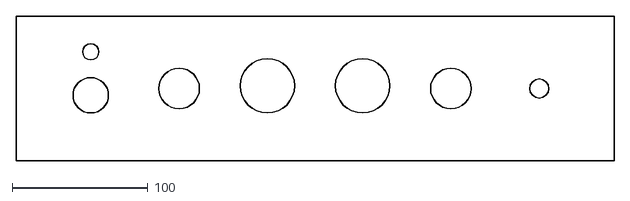
[picture p21: CAD file, 2026-11-07]
hardware/case/DXF/DREWNO_front_rama_15mm.dxf
440.0 x 106.0
