sieraczynski-lab/Soloist-KT88/hardware/case/DXF/AL_pokrywa_gorna.dxf

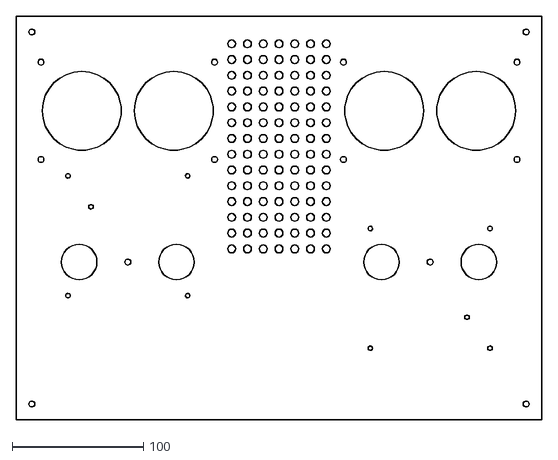
[picture p23: CAD file, 2026-11-07]
hardware/case/DXF/AL_pokrywa_gorna.dxf
400.0 x 307.0
