sieraczynski-lab/Soloist-KT88/hardware/case/Soloist88_obudowa_z_elementami.step

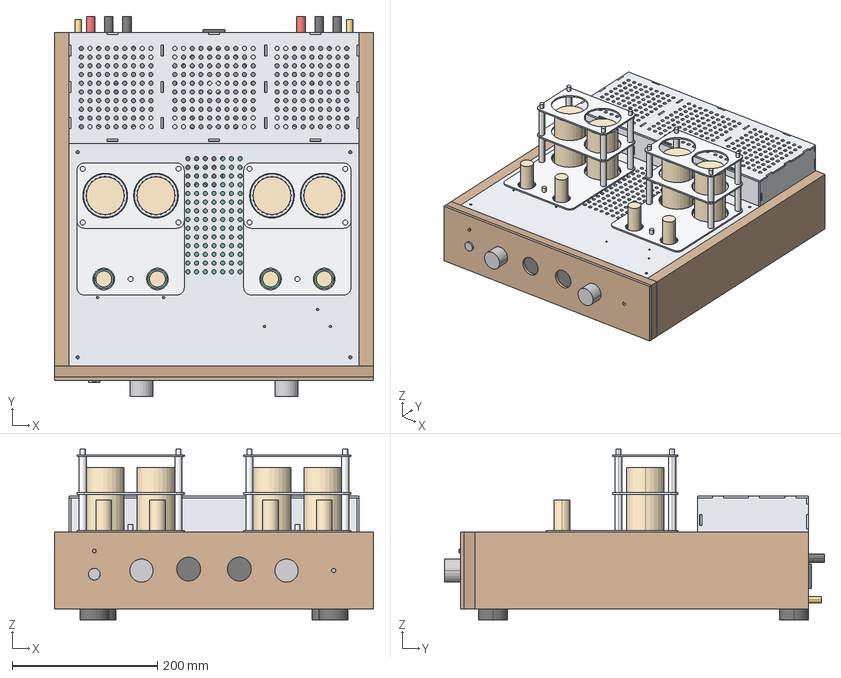
[picture p24: CAD file, 2026-11-07]
hardware/case/Soloist88_obudowa_z_elementami.step
440.0 x 524.0 x 235.5 mm
AL_dno_400x460x3
AL_bok_lewy
AL_bok_prawy
AL_przod_wewn
AL_trafo_przod
AL_trafo_tyl
AL_trafo_przegroda_L
AL_trafo_przegroda_P
AL_trafo_dach
AL_pokrywa_gorna
SS_oslona_L_dolna
SS_oslona_L_srodkowa
SS_oslona_L_gorna
SS_tulejka_L1_a
SS_tulejka_L1_b
SS_tulejka_L2_a
SS_tulejka_L2_b
SS_tulejka_L3_a
SS_tulejka_L3_b
SS_tulejka_L4_a
SS_tulejka_L4_b
SS_oslona_P_dolna
SS_oslona_P_srodkowa
SS_oslona_P_gorna
SS_tulejka_P1_a
SS_tulejka_P1_b
SS_tulejka_P2_a
SS_tulejka_P2_b
SS_tulejka_P3_a
SS_tulejka_P3_b
SS_tulejka_P4_a
SS_tulejka_P4_b
ST_profil_20x20x1.5_L_dl157
ST_profil_20x20x1.5_P_dl157
AL_ekran_sterowania
DREWNO_front_lico_5mm
DREWNO_front_rama_15mm
DREWNO_bok_lewy
DREWNO_bok_prawy
REF_podstawka_KT88 x 4
REF_KT88_cokol x 4
REF_KT88_banka x 4
REF_szpilka_M3 x 8
REF_V101_L_EF86
REF_V102_L_E88CC
REF_V102_R_E88CC
REF_V101_R_EF86
REF_plytka_kanal_L
REF_plytka_kanal_R
REF_plytka_sterowanie
REF_plytka_zasilacz_siec
REF_plytka_zasilacz_hv
REF_C_snapin_0
REF_C_snapin_1
REF_C_snapin_2
REF_C_snapin_3
REF_OT_L
REF_tuleja_TG_35mm x 2
REF_TR1
REF_OT_R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
