sieraczynski-lab/Soloist-KT88/hardware/case/DXF/AL_dno_400x460x3.dxf

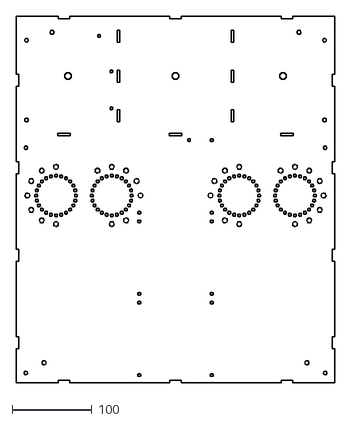
[picture p25: CAD file, 2026-11-07]
hardware/case/DXF/AL_dno_400x460x3.dxf
400.0 x 460.0
