sieraczynski-lab/Soloist-KT88/hardware/case/DXF/SS_oslona_P_dolna.dxf

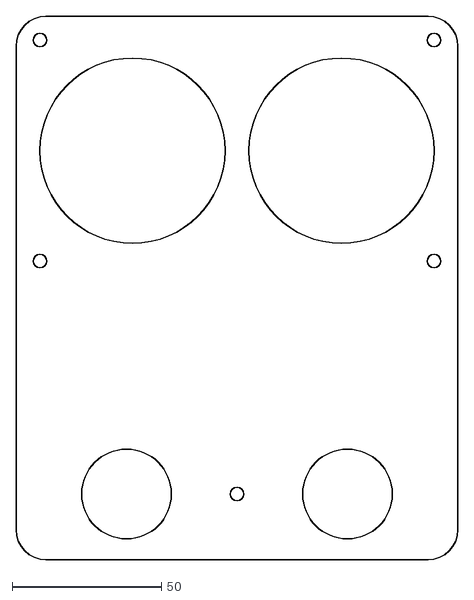
[picture p26: CAD file, 2026-11-07]
hardware/case/DXF/SS_oslona_P_dolna.dxf
148.0 x 182.0
