sieraczynski-lab/Soloist-KT88/hardware/case/DXF/AL_bok_prawy.dxf

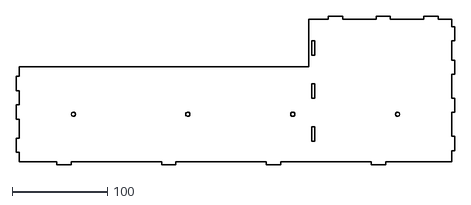
[picture p27: CAD file, 2026-11-07]
hardware/case/DXF/AL_bok_prawy.dxf
460.0 x 156.0
