sieraczynski-lab/Soloist-KT88/hardware/case/DXF/SS_oslona_L_gorna.dxf

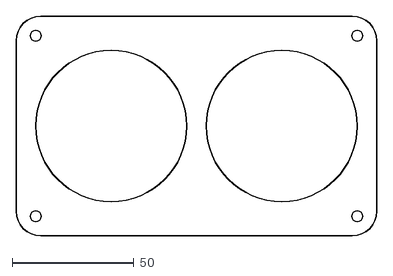
[picture p28: CAD file, 2026-11-07]
hardware/case/DXF/SS_oslona_L_gorna.dxf
148.0 x 90.0
