sieraczynski-lab/Soloist-KT88/hardware/case/DXF/SS_oslona_P_srodkowa.dxf

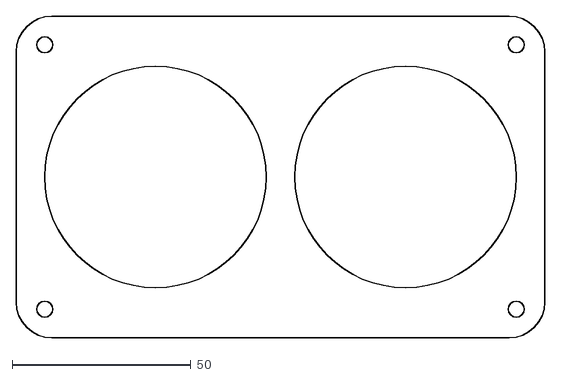
[picture p29: CAD file, 2026-11-07]
hardware/case/DXF/SS_oslona_P_srodkowa.dxf
148.0 x 90.0
