sieraczynski-lab/Soloist-KT88/hardware/case/DXF/AL_trafo_przegroda_L.dxf

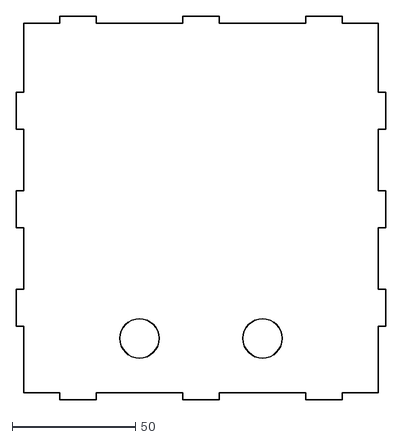
[picture p30: CAD file, 2026-11-07]
hardware/case/DXF/AL_trafo_przegroda_L.dxf
150.0 x 156.0
