sieraczynski-lab/Soloist-KT88/hardware/case/DXF/AL_trafo_tyl.dxf

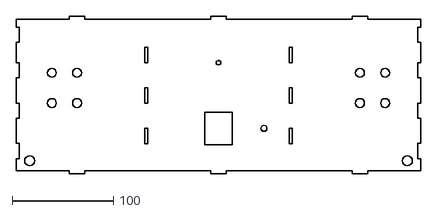
[picture p31: CAD file, 2026-11-07]
hardware/case/DXF/AL_trafo_tyl.dxf
400.0 x 156.0
