sieraczynski-lab/Soloist-KT88/hardware/case/DXF/AL_ekran_sterowania.dxf

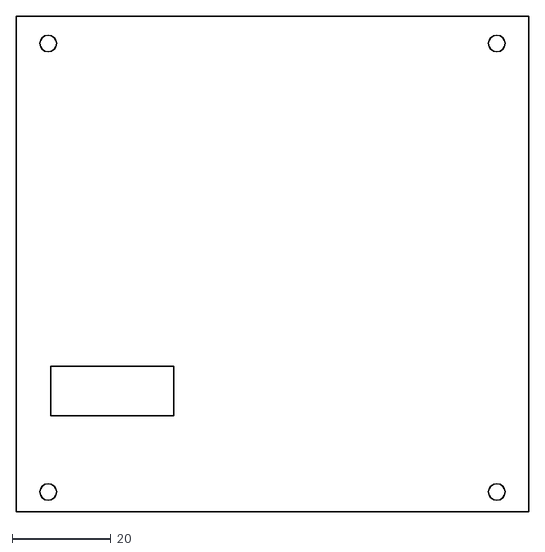
[picture p32: CAD file, 2026-11-07]
hardware/case/DXF/AL_ekran_sterowania.dxf
104.0 x 100.5
