sieraczynski-lab/Soloist-KT88/hardware/case/DXF/AL_przod_wewn.dxf

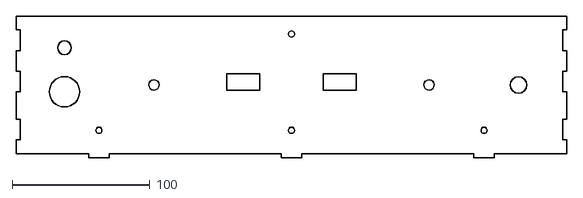
[picture p33: CAD file, 2026-11-07]
hardware/case/DXF/AL_przod_wewn.dxf
400.0 x 103.0
