sieraczynski-lab/Soloist-KT88/hardware/case/DXF/DREWNO_bok_lewy.dxf

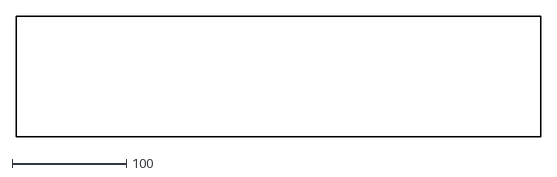
[picture p34: CAD file, 2026-11-07]
hardware/case/DXF/DREWNO_bok_lewy.dxf
460.0 x 106.0
