sieraczynski-lab/Soloist-KT88/hardware/case/DXF/SS_oslona_L_dolna.dxf

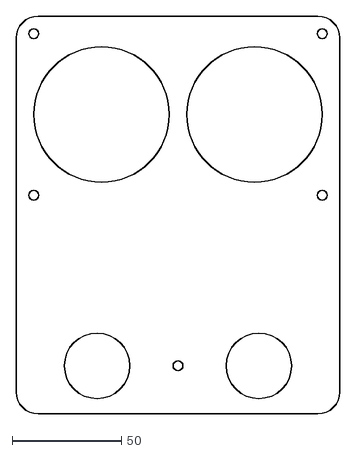
[picture p35: CAD file, 2026-11-07]
hardware/case/DXF/SS_oslona_L_dolna.dxf
148.0 x 182.0
