sieraczynski-lab/Soloist-KT88/hardware/case/DXF/AL_trafo_dach.dxf

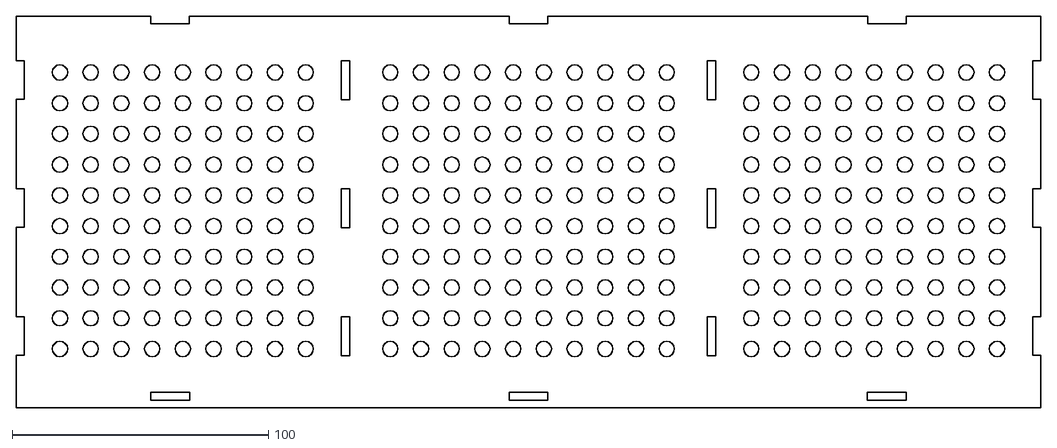
[picture p36: CAD file, 2026-11-07]
hardware/case/DXF/AL_trafo_dach.dxf
400.0 x 153.0
