sieraczynski-lab/Soloist-KT88/hardware/case/DXF/AL_trafo_przod.dxf

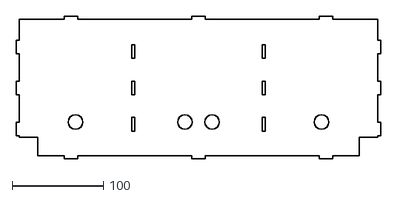
[picture p37: CAD file, 2026-11-07]
hardware/case/DXF/AL_trafo_przod.dxf
400.0 x 156.0
