sieraczynski-lab/Soloist-KT88/hardware/case/DXF/DREWNO_front_lico_5mm.dxf

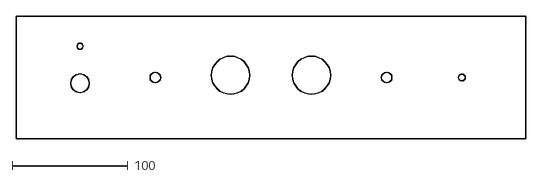
[picture p38: CAD file, 2026-11-07]
hardware/case/DXF/DREWNO_front_lico_5mm.dxf
440.0 x 106.0
