sieraczynski-lab/Soloist-KT88/hardware/pcb/3_pakiet_awaryjny/zasilacz_siec_rozmieszczenie_1do1.pdf

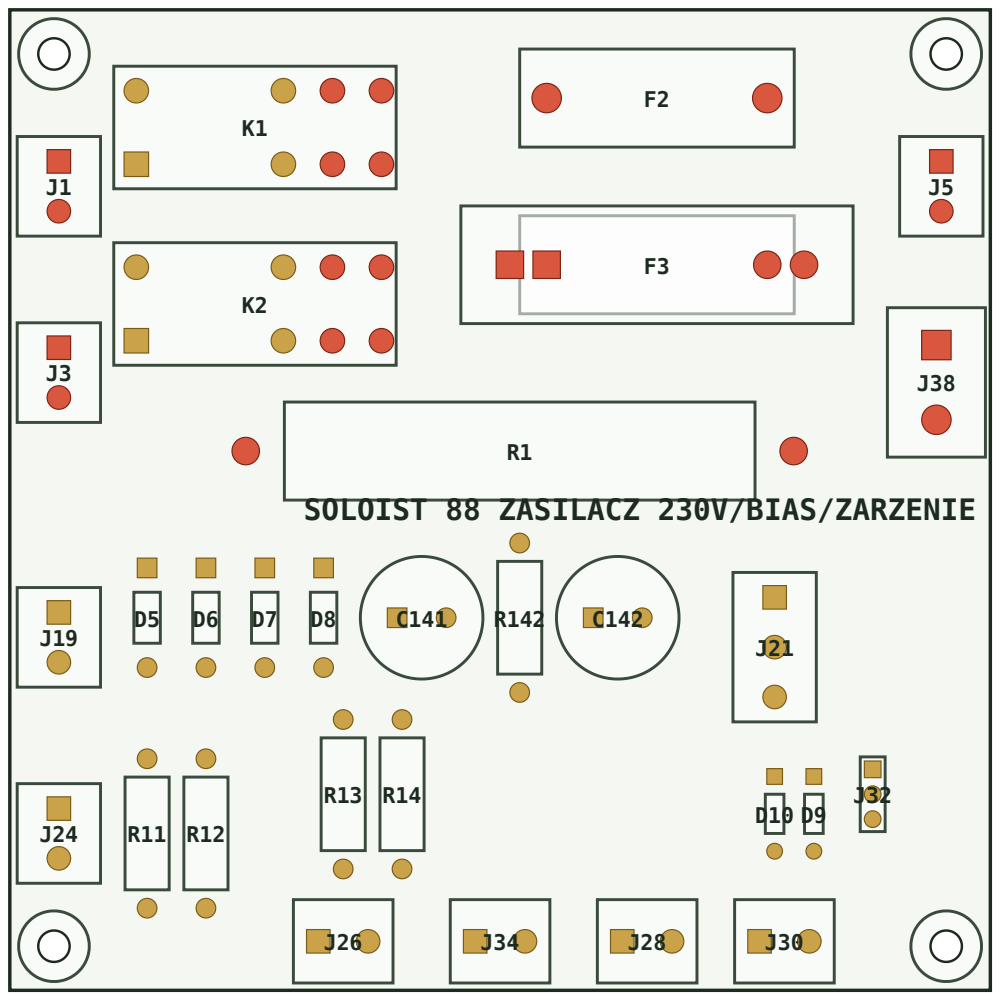
[picture p39: page 1]

SOLOIST 88 ZASILACZ 230V/BIAS/ZARZENIE
