sieraczynski-lab/Soloist-KT88/hardware/pcb/3_pakiet_awaryjny/kanal_rozmieszczenie_1do1.pdf

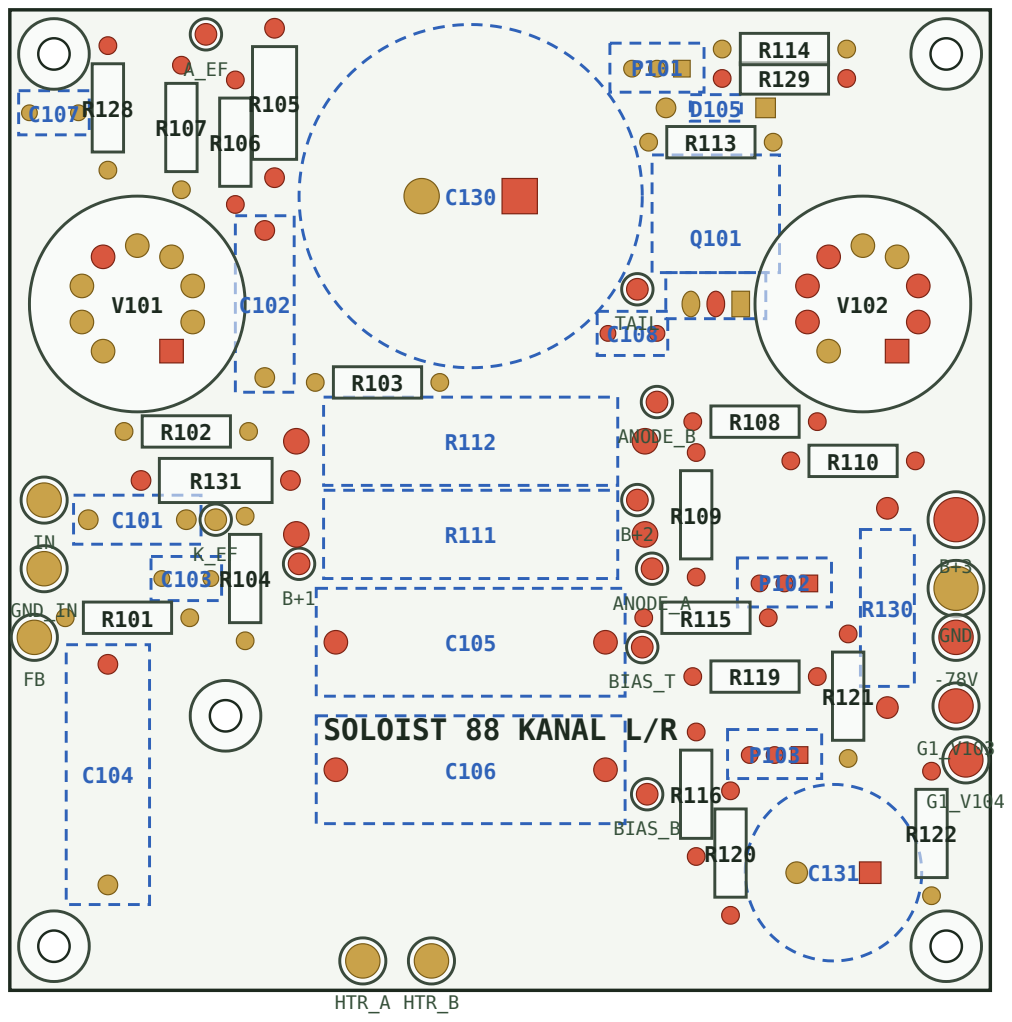
[picture p40: page 1]
