sieraczynski-lab/Soloist-KT88/hardware/pcb/3_pakiet_awaryjny/zasilacz_hv_rozmieszczenie_1do1.pdf

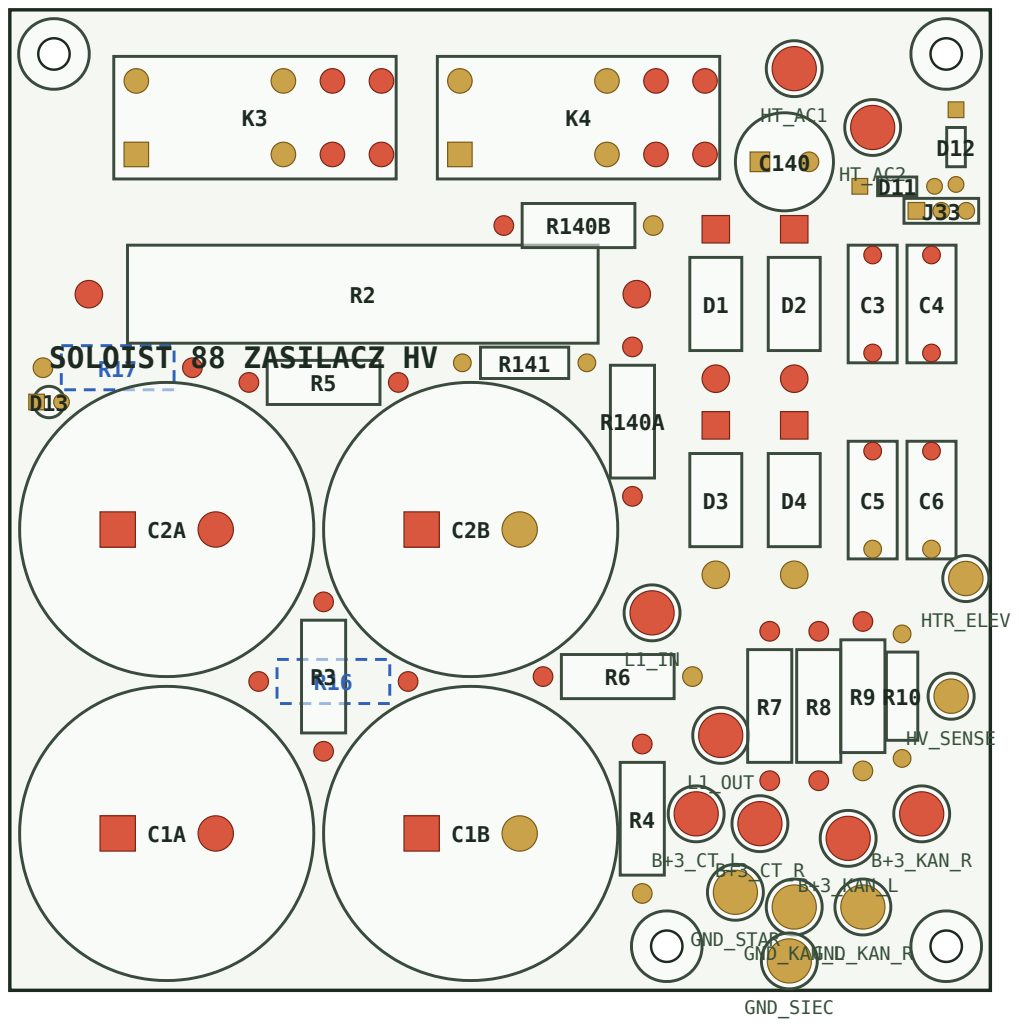
[picture p41: page 1]
