sieraczynski-lab/Soloist-KT88/hardware/pcb/2_projekty_KiCad/KiCad5_dla_EasyEDA_Pro/zasilacz_hv/zasilacz_hv.kicad_pcb

## KiCad design hardware/pcb/2_projekty_KiCad/KiCad5_dla_EasyEDA_Pro/zasilacz_hv/zasilacz_hv.kicad_pcb (2026-11-07)

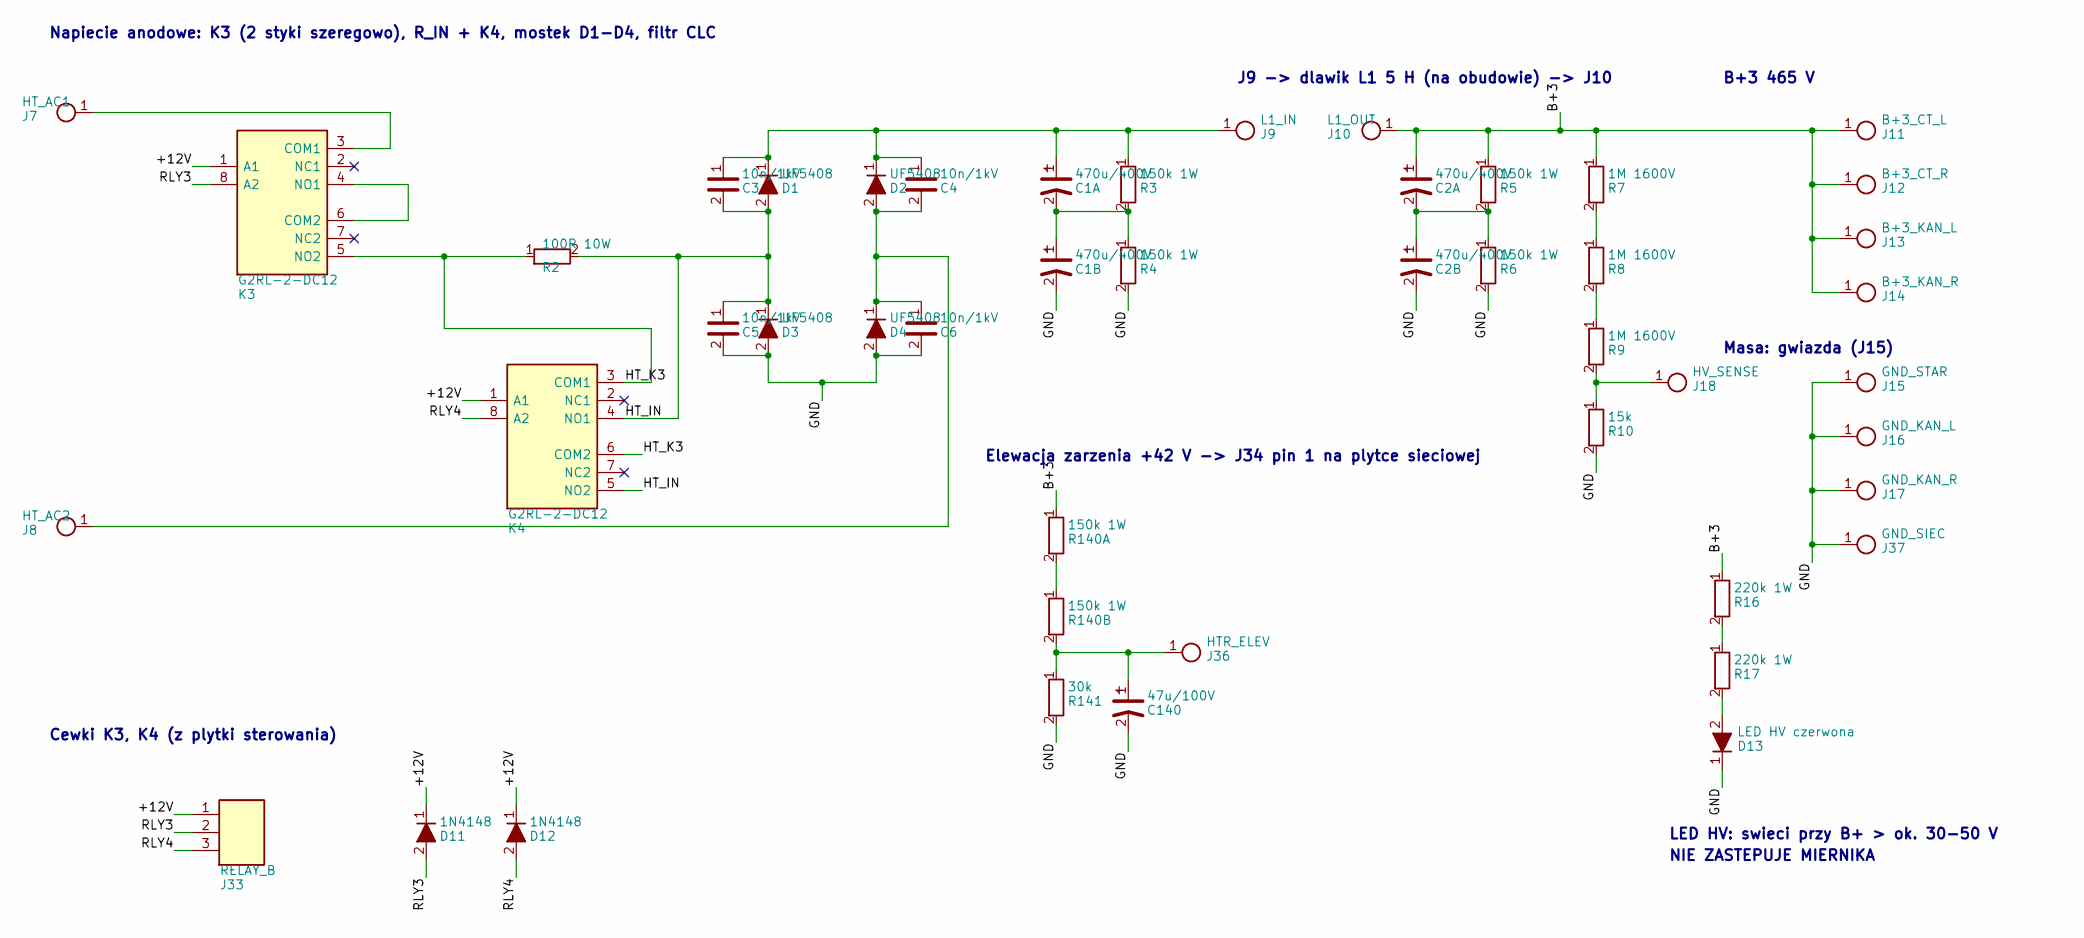
[picture p44: schematic zasilacz_hv.sch, Soloist 88 - zasilacz: wysokie napiecie]

Parts:
C1A, C1B, C2A, C2B: 470u/400V; CP_SnapIn_D30_P10
C3, C4, C5, C6: 10n/1kV; C_Disc_1kV_P10_V
C140: 47u/100V; CP_Radial_D10_P5
D1, D2, D3, D4: UF5408; D_DO-201_P15.24_V
D11: 1N4148; D_DO-35_P7.62
D12: 1N4148; D_DO-35_P7.62_V
D13: LED HV czerwona; LED_D3.0_P2.54
J7: HT_AC1; WirePad_4.5
J8: HT_AC2; WirePad_4.5
J9: L1_IN; WirePad_4.5
J10: L1_OUT; WirePad_4.5
J11: B+3_CT_L; WirePad_4.5
J12: B+3_CT_R; WirePad_4.5
J13: B+3_KAN_L; WirePad_4.5
J14: B+3_KAN_R; WirePad_4.5
J15: GND_STAR; WirePad_4.5
J16: GND_KAN_L; WirePad_4.5
J17: GND_KAN_R; WirePad_4.5
J18: HV_SENSE; WirePad_3.5
J33: RELAY_B; PinHeader_1x03_P2.54_H
J36: HTR_ELEV; WirePad_3.5
J37: GND_SIEC; WirePad_4.5
K3, K4: G2RL-2-DC12; Relay_DPDT_Omron_G2RL
R2: 100R 10W; R_Cement_10W_P55.88
R3, R4, R140A: 150k 1W; R_Axial_1W_P15.24_V
R5, R6, R140B: 150k 1W; R_Axial_1W_P15.24
R7, R8, R9: 1M 1600V; R_Axial_1W_P15.24_V
R10: 15k; R_Axial_0.5W_P12.7_V
R16, R17: 220k 1W; R_Axial_1W_P15.24
R141: 30k; R_Axial_0.5W_P12.7

Connections:
+12V: D11.1 (K), D12.1 (K), J33.1, K3.1 (A1), K4.1 (A1)
B+3: C2A.1, J10.1, J11.1, J12.1, J13.1, J14.1, R5.1, R7.1, R16.1, R140A.1
C1_MID: C1A.2, C1B.1, R3.2, R4.1
C2_MID: C2A.2, C2B.1, R5.2, R6.1
ELEV_MID: R140A.2, R140B.1
GND: C1B.2, C2B.2, C5.2, C6.2, C140.2, D3.2 (A), D4.2 (A), D13.1 (K), J15.1, J16.1, J17.1, J37.1, R4.2, R6.2, R10.2, R141.2
HTR_ELEV: C140.1, J36.1, R140B.2, R141.1
HT_AC1: J7.1, K3.3 (COM1)
HT_AC2: C4.2, C6.1, D2.2 (A), D4.1 (K), J8.1
HT_IN: C3.2, C5.1, D1.2 (A), D3.1 (K), K4.4 (NO1), K4.5 (NO2), R2.2
HT_K3: K3.5 (NO2), K4.3 (COM1), K4.6 (COM2), R2.1
HVS1: R7.2, R8.1
HVS2: R8.2, R9.1
HV_RAW: C1A.1, C3.1, C4.1, D1.1 (K), D2.1 (K), J9.1, R3.1
HV_SENSE: J18.1, R9.2, R10.1
K3_MID: K3.4 (NO1), K3.6 (COM2)
LED_A: D13.2 (A), R17.2
LED_M: R16.2, R17.1
RLY3: D11.2 (A), J33.2, K3.8 (A2)
RLY4: D12.2 (A), J33.3, K4.8 (A2)

Notes on the sheet:
Napiecie anodowe: K3 (2 styki szeregowo), R_IN + K4, mostek D1-D4, filtr CLC
J9 -> dlawik L1 5 H (na obudowie) -> J10
B+3 465 V
Elewacja zarzenia +42 V -> J34 pin 1 na plytce sieciowej
Cewki K3, K4 (z plytki sterowania)
LED HV: swieci przy B+ > ok. 30-50 V
NIE ZASTEPUJE MIERNIKA
Masa: gwiazda (J15)

Board: 2 copper layers, 51 parts (2 on the bottom side), 20 nets, no tracks yet.

Other parts of the board:
MH1, MH2, MH3, MH4: M3; MountingHole_M3
