sieraczynski-lab/Soloist-KT88/hardware/pcb/2_projekty_KiCad/KiCad4_dla_EasyEDA_Standard/ul/ul.kicad_pcb

## KiCad design hardware/pcb/2_projekty_KiCad/KiCad4_dla_EasyEDA_Standard/ul/ul.kicad_pcb (2026-11-07)

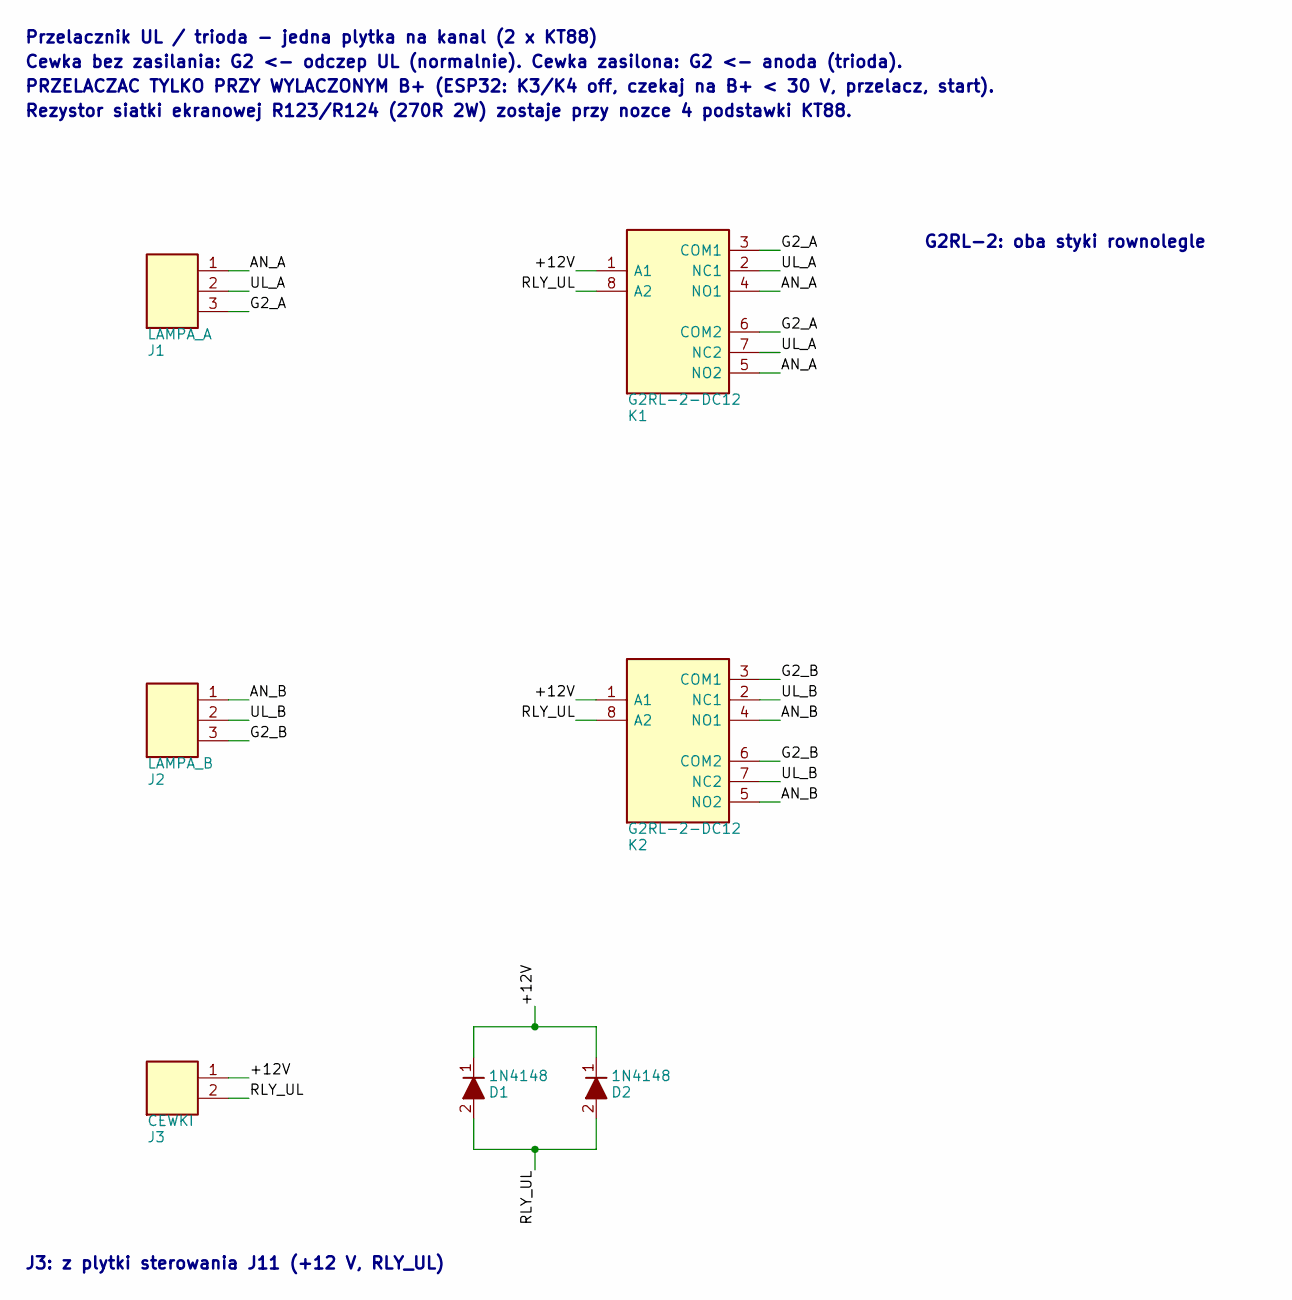
[picture p45: schematic ul.sch, Soloist 88 - przelacznik UL/trioda (x2)]

Parts:
D1: 1N4148; D_DO-35_P7.62_V
D2: 1N4148; D_DO-35_P7.62
J1: LAMPA_A; TerminalBlock_1x03_P7.62_V
J2: LAMPA_B; TerminalBlock_1x03_P7.62_V
J3: CEWKI; TerminalBlock_1x02_P5.08_V
K1, K2: G2RL-2-DC12; Relay_DPDT_Omron_G2RL

Connections:
+12V: D1.1 (K), D2.1 (K), J3.1, K1.1 (A1), K2.1 (A1)
AN_A: J1.1, K1.4 (NO1), K1.5 (NO2)
AN_B: J2.1, K2.4 (NO1), K2.5 (NO2)
G2_A: J1.3, K1.3 (COM1), K1.6 (COM2)
G2_B: J2.3, K2.3 (COM1), K2.6 (COM2)
RLY_UL: D1.2 (A), D2.2 (A), J3.2, K1.8 (A2), K2.8 (A2)
UL_A: J1.2, K1.2 (NC1), K1.7 (NC2)
UL_B: J2.2, K2.2 (NC1), K2.7 (NC2)

Notes on the sheet:
Przelacznik UL / trioda - jedna plytka na kanal (2 x KT88)
Cewka bez zasilania: G2 <- odczep UL (normalnie). Cewka zasilona: G2 <- anoda (trioda).
PRZELACZAC TYLKO PRZY WYLACZONYM B+ (ESP32: K3/K4 off, czekaj na B+ < 30 V, przelacz, start).
Rezystor siatki ekranowej R123/R124 (270R 2W) zostaje przy nozce 4 podstawki KT88.
G2RL-2: oba styki rownolegle
J3: z plytki sterowania J11 (+12 V, RLY_UL)

Board: 2 copper layers, 10 parts (0 on the bottom side), 8 nets, no tracks yet.

Other parts of the board:
MH1, MH2, MH3: M3; MountingHole_M3
