sieraczynski-lab/Soloist-KT88/hardware/pcb/2_projekty_KiCad/KiCad4_dla_EasyEDA_Standard/glosniki/glosniki.kicad_pcb

## KiCad design hardware/pcb/2_projekty_KiCad/KiCad4_dla_EasyEDA_Standard/glosniki/glosniki.kicad_pcb (2026-11-07)

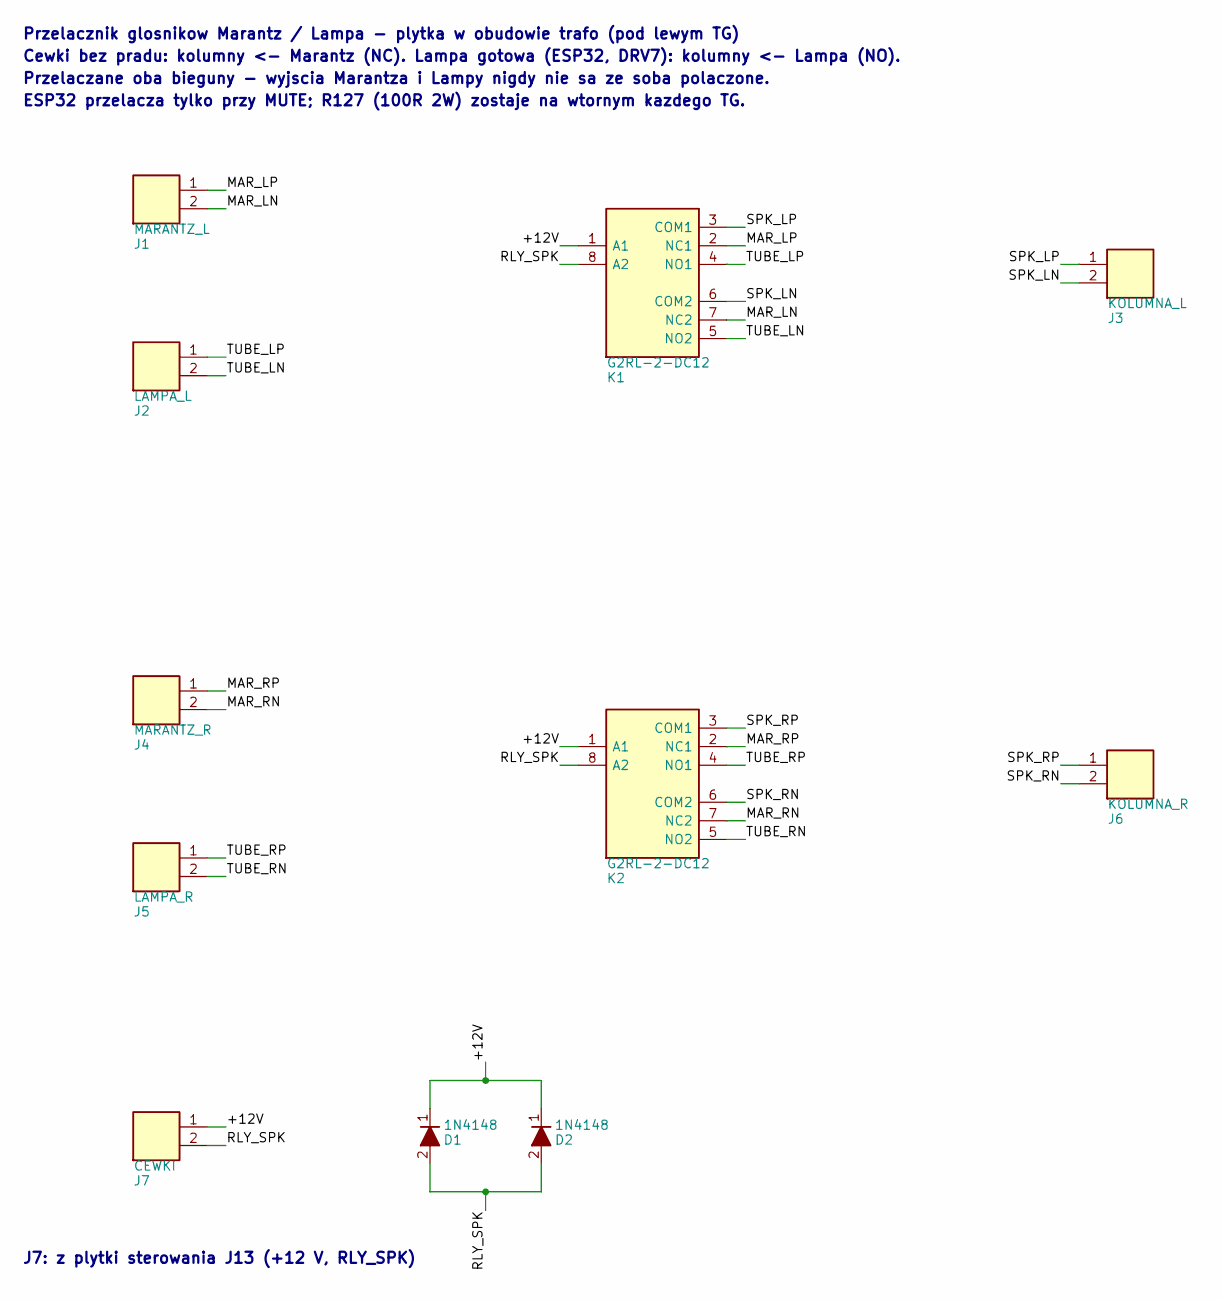
[picture p46: schematic glosniki.sch, Soloist 88 - przelacznik glosnikow Marantz / Lampa]

Parts:
D1, D2: 1N4148; D_DO-35_P7.62
J1: MARANTZ_L; TerminalBlock_1x02_P5.08
J2: LAMPA_L; TerminalBlock_1x02_P5.08
J3: KOLUMNA_L; TerminalBlock_1x02_P5.08
J4: MARANTZ_R; TerminalBlock_1x02_P5.08
J5: LAMPA_R; TerminalBlock_1x02_P5.08
J6: KOLUMNA_R; TerminalBlock_1x02_P5.08
J7: CEWKI; PinHeader_1x02_P2.54
K1, K2: G2RL-2-DC12; Relay_DPDT_Omron_G2RL

Connections:
+12V: D1.1 (K), D2.1 (K), J7.1, K1.1 (A1), K2.1 (A1)
MAR_LN: J1.2, K1.7 (NC2)
MAR_LP: J1.1, K1.2 (NC1)
MAR_RN: J4.2, K2.7 (NC2)
MAR_RP: J4.1, K2.2 (NC1)
RLY_SPK: D1.2 (A), D2.2 (A), J7.2, K1.8 (A2), K2.8 (A2)
SPK_LN: J3.2, K1.6 (COM2)
SPK_LP: J3.1, K1.3 (COM1)
SPK_RN: J6.2, K2.6 (COM2)
SPK_RP: J6.1, K2.3 (COM1)
TUBE_LN: J2.2, K1.5 (NO2)
TUBE_LP: J2.1, K1.4 (NO1)
TUBE_RN: J5.2, K2.5 (NO2)
TUBE_RP: J5.1, K2.4 (NO1)

Notes on the sheet:
Przelacznik glosnikow Marantz / Lampa - plytka w obudowie trafo (pod lewym TG)
Cewki bez pradu: kolumny <- Marantz (NC). Lampa gotowa (ESP32, DRV7): kolumny <- Lampa (NO).
Przelaczane oba bieguny - wyjscia Marantza i Lampy nigdy nie sa ze soba polaczone.
ESP32 przelacza tylko przy MUTE; R127 (100R 2W) zostaje na wtornym kazdego TG.
J7: z plytki sterowania J13 (+12 V, RLY_SPK)

Board: 2 copper layers, 14 parts (0 on the bottom side), 14 nets, no tracks yet.

Other parts of the board:
MH1, MH2, MH3: M3; MountingHole_M3
