sieraczynski-lab/Soloist-KT88/hardware/pcb/2_projekty_KiCad/KiCad5_dla_EasyEDA_Pro/kanal/kanal.kicad_pcb

## KiCad design hardware/pcb/2_projekty_KiCad/KiCad5_dla_EasyEDA_Pro/kanal/kanal.kicad_pcb (2026-11-07)

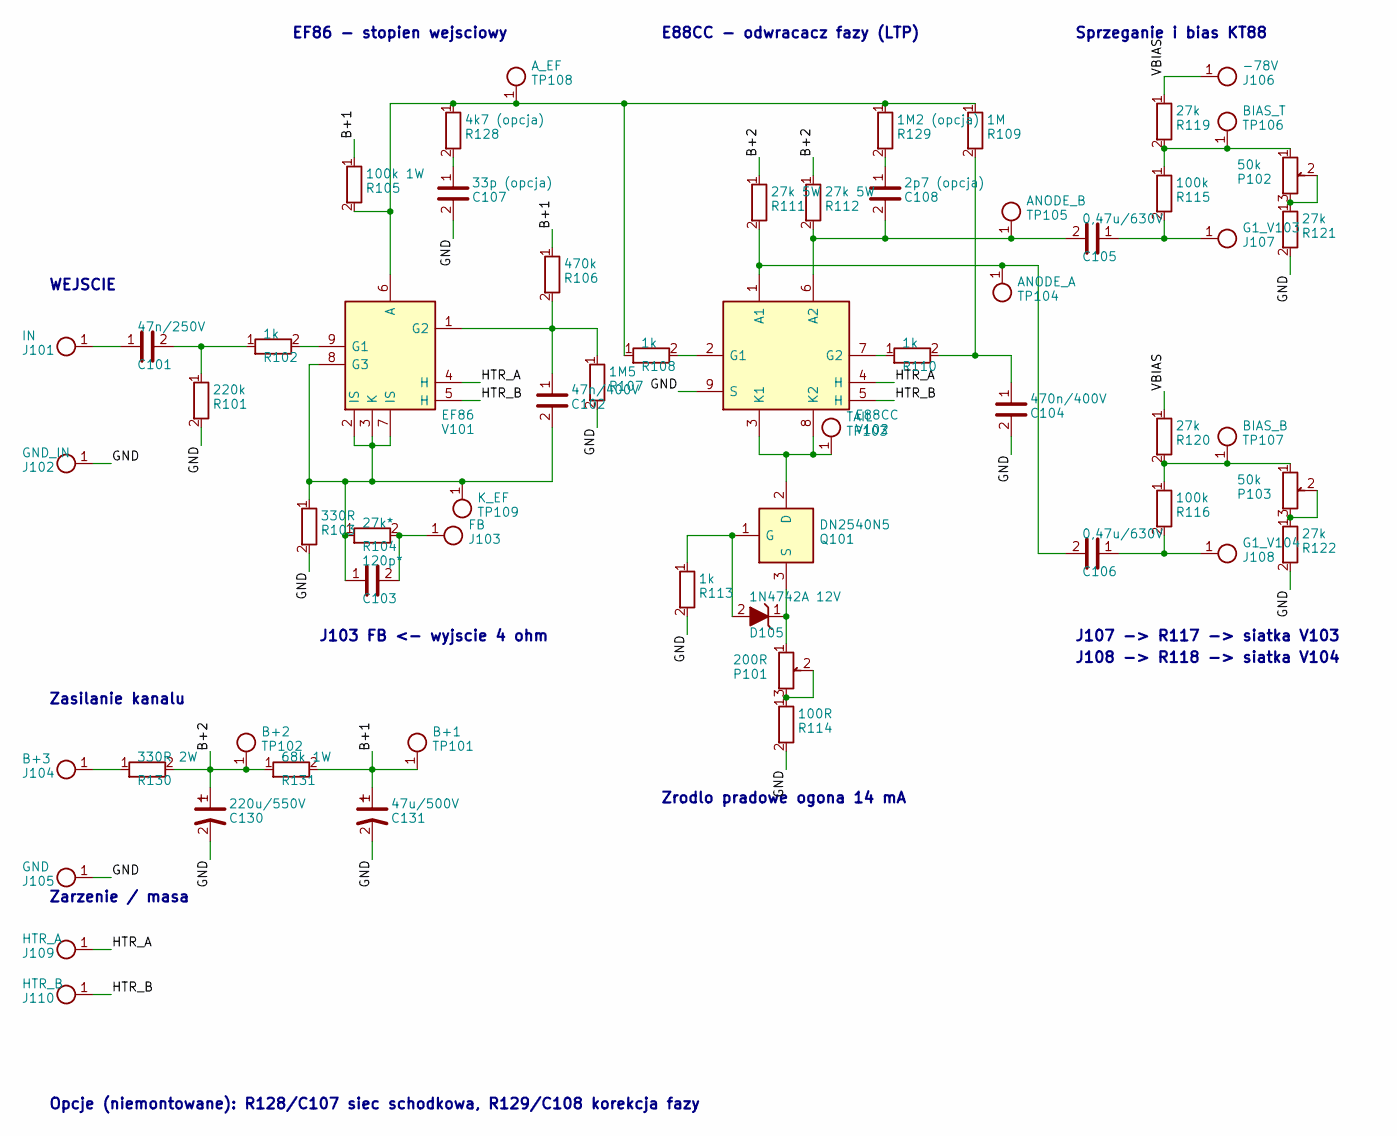
[picture p47: schematic kanal.sch, Soloist 88 - plytka kanalu (x2)]

Parts:
C101: 47n/250V; C_Box_P10_13x5
C102: 47n/400V; C_Box_P15_18x6_V
C103: 120p*; C_Box_P5_7x4
C104: 470n/400V; C_Box_P22.5_26.5x8.5_V
C105, C106: 0,47u/630V; C_Box_P27.5_31.5x11
C107: 33p (opcja); C_Box_P5_7x4
C108: 2p7 (opcja); C_Box_P5_7x4
C130: 220u/550V; CP_SnapIn_D35_P10
C131: 47u/500V; CP_Radial_D18_P7.5
D105: 1N4742A 12V; D_DO-41_P10.16
J101: IN; WirePad_3.5
J102: GND_IN; WirePad_3.5
J103: FB; WirePad_3.5
J104: B+3; WirePad_4.5
J105: GND; WirePad_4.5
J106: -78V; WirePad_3.5
J107: G1_V103; WirePad_3.5
J108: G1_V104; WirePad_3.5
J109: HTR_A; WirePad_3.5
J110: HTR_B; WirePad_3.5
P101: 200R; Trim_3296W
P102, P103: 50k; Trim_3296W
Q101: DN2540N5; TO-220_Vertical_SmallHeatsink
R101: 220k; R_Axial_0.5W_P12.7
R102, R108, R110, R113: 1k; R_Axial_0.5W_P12.7
R103: 330R; R_Axial_0.5W_P12.7
R104: 27k*; R_Axial_0.5W_P12.7_V
R105: 100k 1W; R_Axial_1W_P15.24_V
R106: 470k; R_Axial_0.5W_P12.7_V
R107: 1M5; R_Axial_0.5W_P12.7_V
R109: 1M; R_Axial_0.5W_P12.7_V
R111, R112: 27k 5W; R_Axial_5-7W_P35.56
R114: 100R; R_Axial_0.5W_P12.7
R115: 100k; R_Axial_0.5W_P12.7
R116: 100k; R_Axial_0.5W_P12.7_V
R119: 27k; R_Axial_0.5W_P12.7
R120, R121, R122: 27k; R_Axial_0.5W_P12.7_V
R128: 4k7 (opcja); R_Axial_0.5W_P12.7_V
R129: 1M2 (opcja); R_Axial_0.5W_P12.7
R130: 330R 2W; R_Axial_2W_P20.32_V
R131: 68k 1W; R_Axial_1W_P15.24
TP101: B+1; TestPoint_2
TP102: B+2; TestPoint_2
TP103: TAIL; TestPoint_2
TP104: ANODE_A; TestPoint_2
TP105: ANODE_B; TestPoint_2
TP106: BIAS_T; TestPoint_2
TP107: BIAS_B; TestPoint_2
TP108: A_EF; TestPoint_2
TP109: K_EF; TestPoint_2
V101: EF86; Noval_B9A_PCB
V102: E88CC; Noval_B9A_PCB

Connections:
ANODE_A: C106.2, R111.2, TP104.1, V102.1 (A1)
ANODE_B: C105.2, C108.2, R112.2, TP105.1, V102.6 (A2)
A_EF: R105.2, R108.1, R109.1, R128.1, R129.1, TP108.1, V101.6 (A)
B+1: C131.1, R105.1, R106.1, R131.2, TP101.1
B+2: C130.1, R111.1, R112.1, R130.2, R131.1, TP102.1
B+3: J104.1, R130.1
BIAS_B: P103.1, R116.1, R120.2, TP107.1
BIAS_T: P102.1, R115.1, R119.2, TP106.1
BMID_B: P103.2 (W), P103.3, R122.1
BMID_T: P102.2 (W), P102.3, R121.1
CC_MID: C108.1, R129.2
FB: C103.2, J103.1, R104.2
G1_EF: R102.2, V101.9 (G1)
G2_EF: C102.1, R106.2, R107.1, V101.1 (G2)
GND: C104.2, C107.2, C130.2, C131.2, J102.1, J105.1, R101.2, R103.2, R107.2, R113.2, R114.2, R121.2, R122.2, V102.9 (S)
GRID_B: C106.1, J108.1, R116.2
GRID_T: C105.1, J107.1, R115.2
G_A: R108.2, V102.2 (G1)
G_B: R110.1, V102.7 (G2)
HTR_A: J109.1, V101.4 (H), V102.4 (H)
HTR_B: J110.1, V101.5 (H), V102.5 (H)
IN: C101.1, J101.1
IN2: C101.2, R101.1, R102.1
K_EF: C102.2, C103.1, R103.1, R104.1, TP109.1, V101.2 (IS), V101.3 (K), V101.7 (IS), V101.8 (G3)
N_GB: C104.1, R109.2, R110.2
Q_G: D105.2 (A), Q101.1 (G), R113.1
Q_S: D105.1 (K), P101.1, Q101.3 (S)
RS_MID: P101.2 (W), P101.3, R114.1
STEP: C107.1, R128.2
TAIL: Q101.2 (D), TP103.1, V102.3 (K1), V102.8 (K2)
VBIAS: J106.1, R119.1, R120.1

Notes on the sheet:
WEJSCIE
EF86 - stopien wejsciowy
E88CC - odwracacz fazy (LTP)
Zrodlo pradowe ogona 14 mA
Sprzeganie i bias KT88
Zasilanie kanalu
Zarzenie / masa
J107 -> R117 -> siatka V103
J108 -> R118 -> siatka V104
J103 FB <- wyjscie 4 ohm
Opcje (niemontowane): R128/C107 siec schodkowa, R129/C108 korekcja fazy

Board: 2 copper layers, 65 parts (18 on the bottom side), 31 nets, no tracks yet.

Other parts of the board:
MH101, MH102, MH103, MH104, MH105: M3; MountingHole_M3
