sieraczynski-lab/Soloist-KT88/hardware/pcb/2_projekty_KiCad/KiCad5_dla_EasyEDA_Pro/zasilacz_siec/zasilacz_siec.kicad_pcb

## KiCad design hardware/pcb/2_projekty_KiCad/KiCad5_dla_EasyEDA_Pro/zasilacz_siec/zasilacz_siec.kicad_pcb (2026-11-07)

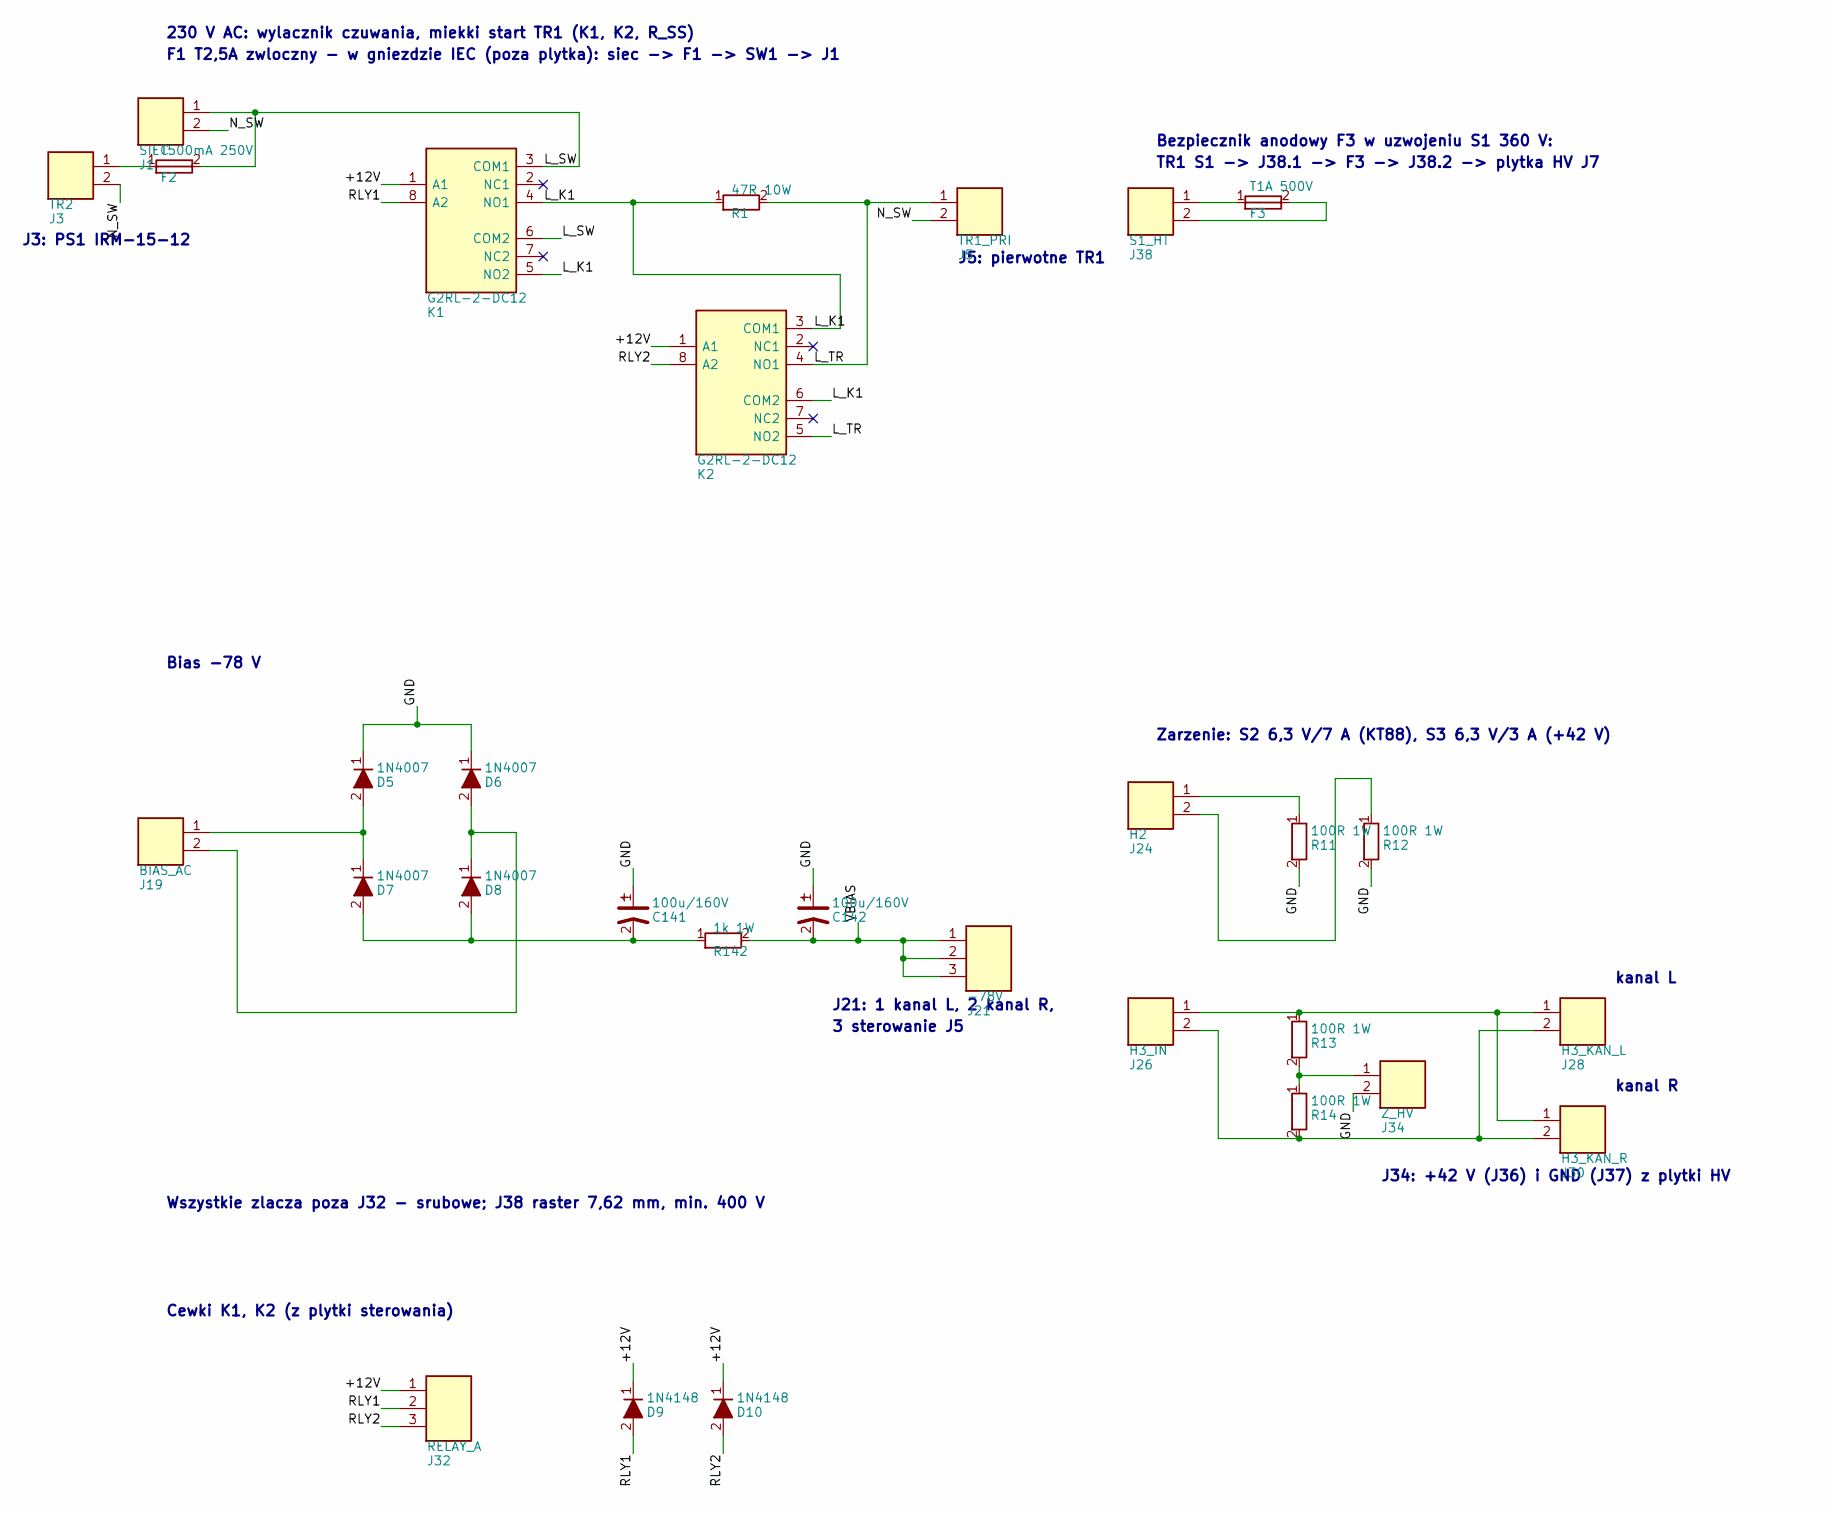
[picture p48: schematic zasilacz_siec.sch, Soloist 88 - zasilacz: siec, bias, zarzenie]

Parts:
C141, C142: 100u/160V; CP_Radial_D12.5_P5
D5, D6, D7, D8: 1N4007; D_DO-41_P10.16_V
D9, D10: 1N4148; D_DO-35_P7.62_V
F2: T500mA 250V; Fuseholder_5x20_Closed_P22.5
F3: T1A 500V; Fuseholder_5x20_P22.5_or_6.3x32_P30
J1: SIEC; TerminalBlock_1x02_P5.08_V
J3: TR2; TerminalBlock_1x02_P5.08_V
J5: TR1_PRI; TerminalBlock_1x02_P5.08_V
J19: BIAS_AC; TerminalBlock_1x02_P5.08_V
J21: -78V; TerminalBlock_1x03_P5.08_V
J24: H2; TerminalBlock_1x02_P5.08_V
J26: H3_IN; TerminalBlock_1x02_P5.08
J28: H3_KAN_L; TerminalBlock_1x02_P5.08
J30: H3_KAN_R; TerminalBlock_1x02_P5.08
J32: RELAY_A; PinHeader_1x03_P2.54
J34: Z_HV; TerminalBlock_1x02_P5.08
J38: S1_HT; TerminalBlock_1x02_P7.62_V
K1, K2: G2RL-2-DC12; Relay_DPDT_Omron_G2RL
R1: 47R 10W; R_Cement_10W_P55.88
R11, R12, R13, R14: 100R 1W; R_Axial_1W_P15.24_V
R142: 1k 1W; R_Axial_1W_P15.24_V

Connections:
+12V: D9.1 (K), D10.1 (K), J32.1, K1.1 (A1), K2.1 (A1)
B_AC1: D5.2 (A), D7.1 (K), J19.1
B_AC2: D6.2 (A), D8.1 (K), J19.2
GND: C141.1, C142.1, D5.1 (K), D6.1 (K), J34.2, R11.2, R12.2
H2_A: J24.1, R11.1
H2_B: J24.2, R12.1
H3_A: J26.1, J28.1, J30.1, R13.1
H3_B: J26.2, J28.2, J30.2, R14.2
HTR_ELEV: J34.1, R13.2, R14.1
HT_F: F3.2, J38.2
HT_TR: F3.1, J38.1
L_K1: K1.4 (NO1), K1.5 (NO2), K2.3 (COM1), K2.6 (COM2), R1.1
L_SW: F2.2, J1.1, K1.3 (COM1), K1.6 (COM2)
L_TR: J5.1, K2.4 (NO1), K2.5 (NO2), R1.2
L_TR2: F2.1, J3.1
N_SW: J1.2, J3.2, J5.2
RLY1: D9.2 (A), J32.2, K1.8 (A2)
RLY2: D10.2 (A), J32.3, K2.8 (A2)
VBIAS: C142.2, J21.1, J21.2, J21.3, R142.2
VB_RAW: C141.2, D7.2 (A), D8.2 (A), R142.1

Notes on the sheet:
230 V AC: wylacznik czuwania, miekki start TR1 (K1, K2, R_SS)
F1 T2,5A zwloczny - w gniezdzie IEC (poza plytka): siec -> F1 -> SW1 -> J1
J5: pierwotne TR1
J3: PS1 IRM-15-12
Bezpiecznik anodowy F3 w uzwojeniu S1 360 V:
TR1 S1 -> J38.1 -> F3 -> J38.2 -> plytka HV J7
Bias -78 V
J21: 1 kanal L, 2 kanal R,
3 sterowanie J5
Zarzenie: S2 6,3 V/7 A (KT88), S3 6,3 V/3 A (+42 V)
kanal L
kanal R
J34: +42 V (J36) i GND (J37) z plytki HV
Cewki K1, K2 (z plytki sterowania)
Wszystkie zlacza poza J32 - srubowe; J38 raster 7,62 mm, min. 400 V

Board: 2 copper layers, 34 parts (0 on the bottom side), 20 nets, no tracks yet.

Other parts of the board:
MH1, MH2, MH3, MH4: M3; MountingHole_M3
