sieraczynski-lab/Soloist-KT88/src/pcb/sch_psu.py

from schwired import WiredSch, sym, Sym
from boards import zasilacz_siec, zasilacz_hv, sterowanie, ul, glosniki


def build_siec():
    b = zasilacz_siec()
    S = WiredSch(b, ("A3", 16535, 11693))
    P, W, L = S.put, S.w, S.lab
    # ---------------- 230 V ----------------
    P("J1", "CONNR_2", 850, 2050); P("J3", "CONNR_2", 350, 2350); P("F2", "FUSE_H", 950, 2300)
    W(("J1", 1), (3200, 2000), (3200, 2300)); W(("J3", 1), ("F2", 1)); W(("F2", 2), (1400, 2300), (1400, 2000))
    L(("J1", 2), "N_SW", 0, stub=(100, 0)); L(("J3", 2), "N_SW", 3, stub=(0, 100))
    P("K1", "RELAY_G2RL", 2600, 2600); W((3200, 2300), ("K1", 3))
    W(("K1", 4), (3500, 2500), (3950, 2500))
    P("R1", "RH", 4100, 2500); W(("R1", 2), (5150, 2500))
    P("J5", "CONN_2", 5450, 2550)
    L(("J5", 2), "N_SW", 2, stub=(-100, 0))
    P("K2", "RELAY_G2RL", 4100, 3500)
    W((3500, 2500), (3500, 2900), (4650, 2900), (4650, 3200), ("K2", 3))
    W((4800, 2500), (4800, 3400), ("K2", 4))
    # G2RL-2: drugi styk rownolegle (etykiety na stykach 1)
    for k, c, n in (("K1", "L_SW", "L_K1"), ("K2", "L_K1", "L_TR")):
        L((k, 3), c, 0); L((k, 4), n, 0)
    # HT fuse in S1 winding
    P("J38", "CONNR_2", 6350, 2550); P("F3", "FUSE_H", 7000, 2500)
    W(("J38", 1), ("F3", 1)); W(("F3", 2), (7350, 2500), (7350, 2600), ("J38", 2))
    # ---------------- bias ----------------
    P("J19", "CONNR_2", 850, 6050)
    P("D5", "D_V", 2000, 5700); P("D7", "D_V", 2000, 6300); P("D6", "D_V", 2600, 5700); P("D8", "D_V", 2600, 6300)
    W(("D5", 2), ("D7", 1)); W(("D6", 2), ("D8", 1)); W(("J19", 1), (2000, 6000))
    W(("J19", 2), (1300, 6100), (1300, 7000), (2850, 7000), (2850, 6000), (2600, 6000))
    W(("D5", 1), (2000, 5400), (2600, 5400), ("D6", 1)); L((2300, 5400), "GND", 1, stub=(0, -100))
    W(("D7", 2), (2000, 6600), (2600, 6600), ("D8", 2)); W((2600, 6600), (3850, 6600))
    P("C141", "CP", 3500, 6450); L(("C141", 1), "GND", 1, stub=(0, -100)); W(("C141", 2), (3500, 6600))
    P("R142", "RH", 4000, 6600); W(("R142", 2), (5000, 6600))
    P("C142", "CP", 4500, 6450); L(("C142", 1), "GND", 1, stub=(0, -100)); W(("C142", 2), (4500, 6600))
    P("J21", "CONN_3", 5500, 6700)
    W((5000, 6600), ("J21", 1)); W((5000, 6700), ("J21", 2)); W((5000, 6800), ("J21", 3))
    W((5000, 6600), (5000, 6800)); L((4750, 6600), "VBIAS", 1, stub=(0, -100))
    # ---------------- heaters ----------------
    P("J24", "CONNR_2", 6350, 5850)
    P("R11", "R", 7200, 6050); P("R12", "R", 7600, 6050)
    W(("J24", 1), (7200, 5800), ("R11", 1))
    W(("J24", 2), (6750, 5900), (6750, 6600), (7400, 6600), (7400, 5700), (7600, 5700), ("R12", 1))
    L(("R11", 2), "GND", 3, stub=(0, 100)); L(("R12", 2), "GND", 3, stub=(0, 100))
    P("J26", "CONNR_2", 6350, 7050)
    P("J28", "CONN_2", 8800, 7050); P("J30", "CONN_2", 8800, 7650)
    W(("J26", 1), ("J28", 1))
    W(("J26", 2), (6750, 7100), (6750, 7700), ("J30", 2))
    W((8200, 7700), (8200, 7100), ("J28", 2))
    W((8300, 7000), (8300, 7600), ("J30", 1))
    P("R13", "R", 7200, 7150); P("R14", "R", 7200, 7550)
    W((7200, 7000), ("R13", 1)); W(("R14", 2), (7200, 7700))
    P("J34", "CONN_2", 7800, 7400)
    W(("R13", 2), ("R14", 1)); W((7200, 7350), ("J34", 1)); L(("J34", 2), "GND", 3, stub=(0, 100))
    P("J32", "CONN_3", 2500, 9200); P("D9", "D_V", 3500, 9200); P("D10", "D_V", 4000, 9200)
    for x, y, t in ((900, 1600, "230 V AC: wylacznik czuwania, miekki start TR1 (K1, K2, R_SS)"),
                    (900, 1720, "F1 T2,5A zwloczny - w gniezdzie IEC (poza plytka): siec -> F1 -> SW1 -> J1"),
                    (5300, 2850, "J5: pierwotne TR1"), (100, 2750, "J3: PS1 IRM-15-12"),
                    (6400, 2200, "Bezpiecznik anodowy F3 w uzwojeniu S1 360 V:"),
                    (6400, 2320, "TR1 S1 -> J38.1 -> F3 -> J38.2 -> plytka HV J7"),
                    (900, 5100, "Bias -78 V"), (4600, 7000, "J21: 1 kanal L, 2 kanal R,"), (4600, 7120, "3 sterowanie J5"),
                    (6400, 5500, "Zarzenie: S2 6,3 V/7 A (KT88), S3 6,3 V/3 A (+42 V)"),
                    (8950, 6850, "kanal L"), (8950, 7450, "kanal R"),
                    (7650, 7950, "J34: +42 V (J36) i GND (J37) z plytki HV"),
                    (900, 8700, "Cewki K1, K2 (z plytki sterowania)"),
                    (900, 8100, "Wszystkie zlacza poza J32 - srubowe; J38 raster 7,62 mm, min. 400 V")):
        S.note(x, y, t, 60)
    S.autolabel()
    return S


def build_hv():
    b = zasilacz_hv()
    S = WiredSch(b, ("A2", 23386, 16535))
    P, W, L = S.put, S.w, S.lab
    # ---------------- HT ----------------
    P("J7", "PAD_L", 6500, 2000)
    P("K3", "RELAY_G2RL", 7700, 2500)
    W(("J7", 1), (8300, 2000), (8300, 2200), ("K3", 3))
    W(("K3", 4), (8400, 2400), (8400, 2600), ("K3", 6))
    W(("K3", 5), (8600, 2800), (9050, 2800))
    P("R2", "RH", 9200, 2800); W(("R2", 2), (10400, 2800))
    P("K4", "RELAY_G2RL", 9200, 3800)
    W((8600, 2800), (8600, 3200), (9750, 3200), (9750, 3500), ("K4", 3))
    W(("K4", 4), (9900, 3700), (9900, 2800))
    L(("K4", 3), "HT_K3", 0); L(("K4", 4), "HT_IN", 0)
    # bridge
    P("D1", "D_V", 10400, 2400); P("D3", "D_V", 10400, 3200); P("D2", "D_V", 11000, 2400); P("D4", "D_V", 11000, 3200)
    W(("D1", 2), ("D3", 1)); W(("D2", 2), ("D4", 1))
    W(("D1", 1), (10400, 2100), (11000, 2100), ("D2", 1)); W((11000, 2100), (12900, 2100))
    W(("D3", 2), (10400, 3500), (11000, 3500), ("D4", 2)); L((10700, 3500), "GND", 3, stub=(0, 100))
    P("C3", "C", 10150, 2400); P("C5", "C", 10150, 3200); P("C4", "C", 11250, 2400); P("C6", "C", 11250, 3200)
    W(("C3", 1), ("D1", 1)); W(("C3", 2), ("D1", 2)); W(("C5", 1), ("D3", 1)); W(("C5", 2), ("D3", 2))
    W(("C4", 1), ("D2", 1)); W(("C4", 2), ("D2", 2)); W(("C6", 1), ("D4", 1)); W(("C6", 2), ("D4", 2))
    P("J8", "PAD_L", 6500, 4300); W(("J8", 1), (11400, 4300), (11400, 2800), (11000, 2800))
    # filter C1
    P("C1A", "CP", 12000, 2400); P("C1B", "CP", 12000, 2850); P("R3", "R", 12400, 2400); P("R4", "R", 12400, 2850)
    W((12000, 2100), ("C1A", 1)); W(("C1A", 2), ("C1B", 1)); W((12400, 2100), ("R3", 1)); W(("R3", 2), ("R4", 1))
    W(("C1A", 2), ("R3", 2))
    L(("C1B", 2), "GND", 3, stub=(0, 100)); L(("R4", 2), "GND", 3, stub=(0, 100))
    P("J9", "PAD", 13050, 2100); P("J10", "PAD_L", 13750, 2100)
    W(("J10", 1), (16200, 2100))
    P("C2A", "CP", 14000, 2400); P("C2B", "CP", 14000, 2850); P("R5", "R", 14400, 2400); P("R6", "R", 14400, 2850)
    W((14000, 2100), ("C2A", 1)); W(("C2A", 2), ("C2B", 1)); W((14400, 2100), ("R5", 1)); W(("R5", 2), ("R6", 1))
    W(("C2A", 2), ("R5", 2))
    L(("C2B", 2), "GND", 3, stub=(0, 100)); L(("R6", 2), "GND", 3, stub=(0, 100))
    L((14800, 2100), "B+3", 1, stub=(0, -100))
    # HV sense
    P("R7", "R", 15000, 2400); P("R8", "R", 15000, 2850); P("R9", "R", 15000, 3300); P("R10", "R", 15000, 3750)
    W((15000, 2100), ("R7", 1)); W(("R7", 2), ("R8", 1)); W(("R8", 2), ("R9", 1)); W(("R9", 2), ("R10", 1))
    L(("R10", 2), "GND", 3, stub=(0, 100))
    P("J18", "PAD", 15450, 3500); W((15000, 3500), ("J18", 1))
    # outputs B+3
    for ref, y in (("J11", 2100), ("J12", 2400), ("J13", 2700), ("J14", 3000)):
        P(ref, "PAD", 16500, y)
        W((16200, y), (ref, 1))
    W((16200, 2100), (16200, 3000))
    for ref, y in (("J15", 3500), ("J16", 3800), ("J17", 4100)):
        P(ref, "PAD", 16500, y)
        W((16200, y), (ref, 1))
    P("J37", "PAD", 16500, 4400); W((16200, 4400), ("J37", 1))
    W((16200, 3500), (16200, 4400)); L((16200, 4400), "GND", 3, stub=(0, 100))
    # elevation
    P("R140A", "R", 12000, 4350); P("R140B", "R", 12000, 4800); P("R141", "R", 12000, 5250); P("C140", "CP", 12400, 5300); P("J36", "PAD", 12750, 5000)
    W(("R140A", 2), ("R140B", 1))
    W(("R140B", 2), ("R141", 1)); W((12000, 5000), ("J36", 1)); W((12400, 5000), ("C140", 1))
    L(("R140A", 1), "B+3", 1, stub=(0, -100))
    # HV LED
    P("R16", "R", 15700, 4700); L(("R16", 1), "B+3", 1, stub=(0, -100))
    P("R17", "R", 15700, 5100); W(("R16", 2), ("R17", 1))
    P("D13", "D", 15700, 5500); W(("R17", 2), ("D13", 2)); L(("D13", 1), "GND", 3, stub=(0, 100))
    # coils
    P("J33", "CONN_3", 7500, 6000); P("D11", "D_V", 8500, 6000); P("D12", "D_V", 9000, 6000)
    for x, y, t in ((6400, 1600, "Napiecie anodowe: K3 (2 styki szeregowo), R_IN + K4, mostek D1-D4, filtr CLC"),
                    (13000, 1850, "J9 -> dlawik L1 5 H (na obudowie) -> J10"),
                    (15700, 1850, "B+3 465 V"), (11600, 3950, "Elewacja zarzenia +42 V -> J34 pin 1 na plytce sieciowej"),
                    (6400, 5500, "Cewki K3, K4 (z plytki sterowania)"),
                    (15400, 6050, "LED HV: swieci przy B+ > ok. 30-50 V"),
                    (15400, 6170, "NIE ZASTEPUJE MIERNIKA"), (15700, 3350, "Masa: gwiazda (J15)")):
        S.note(x, y, t, 60)
    S.autolabel()
    return S


# ESP32 symbol with used pins on the right side, arranged for straight wiring
_R = [("SDA/IO8", "L12", 1400), ("SCL/IO9", "L15", 1300), ("IO10", "L16", 1100), ("IO11", "L17", 1000), ("IO12", "L18", 900),
      ("IO13", "L19", 800), ("IO14", "L20", 700), ("IO4", "L4", 500), ("IO5", "L5", 400), ("IO6", "L6", 200),
      ("IO7", "L7", 100), ("IO15", "L8", 0), ("IO16", "L9", -100), ("IO17", "L10", -300), ("IO18", "L11", -400), ("IO1", "R4", -600)]
_L = [("3V3", "L1", 1400), ("3V3", "L2", 1300), ("5V", "L21", 1100), ("GND", "L22", 900), ("GND", "R1", 800),
      ("GND", "R21", 700), ("GND", "R22", 600)]
_NC = [("RST", "L3"), ("IO3", "L13"), ("IO46", "L14")] + \
      [(n, "R%d" % (k + 2)) for k, n in enumerate(["TX", "RX", None, "IO2", "IO42", "IO41", "IO40", "IO39", "IO38", "IO37",
                                                  "IO36", "IO35", "IO0", "IO45", "IO48", "IO47", "IO21", "IO20", "IO19"]) if n]
_pins = [(n.replace("/", "_"), num, 600, y, 150, "L", "P") for (n, num, y) in _R] + \
        [(n, num, -600, y, 150, "R", "P") for (n, num, y) in _L] + \
        [(n, num, -600, 400 - 100 * k, 150, "R", "P") for k, (n, num) in enumerate(_NC)]
sym(Sym("ESP32W", "U", _pins, ["S -450 -2000 450 1500 0 1 10 f"], show_names=True, value_pos=(-450, 1530), ref_pos=(-450, 1610)))


def build_ctl():
    b = sterowanie()
    S = WiredSch(b, ("A2", 23386, 16535))
    P, W, L = S.put, S.w, S.lab
    P("U1", "ESP32W", 2200, 5000)
    # ---------------- zasilanie ----------------
    P("U2", None, 5500, 1500); P("C1", "CP", 4900, 1800); P("C2", "CP", 6100, 1800)
    P("J1", "CONNR_2", 2600, 1550); P("PS1", "IRM", 3500, 1600)
    W(("J1", 1), ("PS1", 1)); W(("J1", 2), (2950, 1600), (2950, 1700), ("PS1", 2))
    W(("PS1", 4), (4650, 1500)); L(("PS1", 3), "GND", 3, stub=(0, 100))
    W((4650, 1500), ("U2", 2)); W((4900, 1500), ("C1", 1)); L((4650, 1500), "+12V", 1, stub=(0, -100))
    L(("C1", 2), "GND", 3, stub=(0, 100)); W(("U2", 1), (5450, 1950), (5550, 1950), ("U2", 4)); L((5500, 1950), "GND", 3, stub=(0, 100))
    W(("U2", 3), (6400, 1500)); L((6400, 1500), "+5V", 0); W((6100, 1500), ("C2", 1)); L(("C2", 2), "GND", 3, stub=(0, 100))
    # ---------------- przekazniki ----------------
    P("U3", None, 6000, 4300)
    for (pin, inp) in (("L16", 1), ("L17", 2), ("L18", 3), ("L19", 4), ("L20", 5)):
        W(("U1", pin), ("U3", inp))
    W(("U3", 8), (5450, 4600), (5450, 4750), ("U3", 9))
    L((5450, 4750), "GND", 3, stub=(0, 100))
    P("J2", None, 7000, 4000)
    for o, pn in ((18, 2), (17, 3), (16, 4), (15, 5)):
        W(("U3", o), ("J2", pn))
    P("J3", None, 7000, 4550)
    P("J11", None, 7000, 5150); P("J13", None, 7000, 5750)
    # wejscie trigger 12 V (Marantz) - transoptor
    P("J12", "CONNR_2", 1500, 9550); P("R35", "RH", 2150, 9500); P("D13", "D_V", 2450, 9700); P("U8", None, 3150, 9550)
    P("R36", "R", 3850, 9200); P("C17", "C", 4050, 9850)
    W(("J12", 1), ("R35", 1)); W(("R35", 2), (2450, 9500), ("U8", 1)); W(("D13", 1), (2450, 9500))
    W(("J12", 2), (1950, 9600), (1950, 9900), (2450, 9900)); W(("D13", 2), (2450, 9900)); W((2450, 9900), (2700, 9900), (2700, 9600), ("U8", 2))
    W(("U8", 4), (3850, 9500)); W(("R36", 2), (3850, 9500)); W((3850, 9500), (4050, 9500), ("C17", 1)); W((4050, 9500), (4300, 9500))
    L((4300, 9500), "TRIG_IN", 0)
    # ---------------- uzytkownik ----------------
    P("J6", None, 4800, 5200); P("R8", "R", 3800, 4950)
    W(("U1", "L4"), (3500, 4500), (3500, 5200), ("J6", 2)); W(("R8", 2), (3800, 5200))
    P("J7", None, 4800, 5700); W(("U1", "L5"), (3400, 4600), (3400, 5700), ("J7", 2))
    P("J9", None, 4800, 6600)
    W(("U1", "L6"), (3300, 4800), (3300, 6400), ("J9", 1)); W(("U1", "L7"), (3200, 4900), (3200, 6500), ("J9", 2))
    W(("U1", "L8"), (3100, 5000), (3100, 6600), ("J9", 3)); W(("U1", "L9"), (3000, 5100), (3000, 6700), ("J9", 4))
    P("J8", None, 6300, 2800)
    # ---------------- ADC ----------------
    P("U4", None, 11000, 3300); P("U5", None, 11000, 4700)
    P("C9", "C", 10000, 3100); P("C10", "C", 10000, 4500); P("R9", "R", 9300, 3100); P("R10", "R", 9700, 3100)
    # filtry IK
    for i, (n, R, C, Dl, Du) in enumerate((("IK_L1", "R1", "C3", "D1", "D2"), ("IK_L2", "R2", "C4", "D3", "D4"),
                                           ("IK_R1", "R3", "C5", "D5", "D6"), ("IK_R2", "R4", "C6", "D7", "D8"))):
        x = 13500 + 1000 * i
        P(R, "R", x, 3300); P(C, "C", x, 3750); P(Du, "D_V", x + 250, 3300); P(Dl, "D_V", x + 250, 3750)
        W((R, 2), (C, 1)); W((C, 1), (Dl, 1)); W((Du, 2), (Dl, 1)); W((Dl, 1), (x + 500, 3600))
        L((x + 500, 3600), n + "F", 0)
    P("R5", "R", 13500, 5150); P("R6", "RH", 13900, 5300); P("C7", "C", 13500, 5600)
    W(("R5", 2), ("R6", 1)); W(("R5", 2), ("C7", 1)); W(("R5", 2), (13300, 5300)); L((13300, 5300), "VB_F", 2)
    P("R7", "RH", 13900, 6200); P("C8", "C", 14200, 6500)
    W(("R7", 2), (14200, 6200), ("C8", 1)); W((14200, 6200), (14450, 6200)); L((14450, 6200), "HV_F", 0)
    P("J4", None, 18500, 3500); P("J5", None, 18500, 5300)
    # ---------------- korekta biasu ----------------
    P("U6", None, 9800, 8300); P("C11", "C", 8800, 8000)
    P("U7", None, 12300, 8300); P("C12", "C", 11300, 7800)
    for i, k in enumerate(("L1", "L2", "R1", "R2")):
        y = 7700 + 600 * i
        x = 13700
        P("R%d" % (15 + i), "RH", x, y - 250)          # 20k OUT -> FB
        P("R%d" % (11 + i), "R", x + 400, y + 100)     # 10k FB -> GND
        P("R%d" % (19 + i), "RH", x + 900, y)          # 10k filtr przed LM324
        P("C%d" % (13 + i), "C", x + 1300, y + 150)
        W(("R%d" % (19 + i), 2), (x + 1450, y)); L((x + 1450, y), "DACF_" + k, 0)
        P("D%d" % (9 + i), "D_V", x + 1900, y + 150)   # zacisk wyjscia OA
        P("R%d" % (23 + i), "RH", x + 2050, y)         # 68k
        P("R%d" % (27 + i), "R", x + 2400, y + 250)    # 33k do szyny biasu
        P("R%d" % (31 + i), "RH", x + 2700, y)         # 1k wyjscie
        W((x + 1700, y), ("R%d" % (23 + i), 1)); L((x + 1700, y), "OA_" + k, 2)
        W(("R%d" % (23 + i), 2), ("R%d" % (31 + i), 1)); W(("R%d" % (27 + i), 1), (x + 2400, y))
    P("J10", None, 17400, 8200)
    for x, y, t in ((1500, 3200, "ESP32-S3-DevKitC-1"), (3600, 1100, "Zasilanie 12 V -> 5 V"), (5600, 3700, "Sterowanie przekaznikami"),
                    (10300, 2700, "Przetworniki ADC ADS1115 (I2C 0x48, 0x49)"), (13300, 2700, "Filtry i zabezpieczenie wejsc pradu katod KT88"),
                    (13300, 4800, "Pomiar biasu -78 V"), (13300, 5900, "Pomiar B+ (opcja)"), (4300, 7100, "Zlacza uzytkownika"),
                    (6200, 2450, "Wyswietlacz I2C"), (18000, 3000, "Zlacza pomiarowe"),
                    (6600, 5600, "J11: przekazniki UL/trioda (plytki UL), J13: przelacznik glosnikow"),
                    (1300, 8850, "Wejscie TRIGGER 12 V z Marantza (jack 3,5 mm izolowany od obudowy) - masa oddzielona transoptorem"),
                    (8600, 7200, "Automatyczna korekta biasu KT88: MCP4728 (I2C 0x60) -> filtr 10k/1u -> LM324 x3 -> przesuwnik 68k/33k do szyny biasu -> 1k -> TP106/TP107"),
                    (8600, 7320, "Zakres korekty ok. +-0,7 V na siatce (ok. +-6 mA); awaria sterowania przesuwa bias najwyzej o ok. 0,85 V"),
                    (8600, 7440, "D9-D12: bez zasilania 12 V wyjscie LM324 nie schodzi ponizej masy")):
        S.note(x, y, t, 60)
    S.autolabel()
    return S

def build_glosniki():
    b = glosniki()
    S = WiredSch(b, ("A4", 11693, 8268))
    P, W, L = S.put, S.w, S.lab
    for k, (ch, K, y) in enumerate((("L", "K1", 2600), ("R", "K2", 5300))):
        P(K, None, 4200, y)
        j0 = 1 + 3 * k
        P("J%d" % j0, "CONNR_2", 1500, y - 450); P("J%d" % (j0 + 1), "CONNR_2", 1500, y + 450); P("J%d" % (j0 + 2), "CONN_2", 6800, y - 50)
    P("J7", "CONNR_2", 1500, 7200); P("D1", "D_V", 3000, 7200); P("D2", "D_V", 3600, 7200)
    W(("D1", 1), (3000, 6900), (3600, 6900), ("D2", 1)); W(("D1", 2), (3000, 7500), (3600, 7500), ("D2", 2))
    L((3300, 6900), "+12V", 1, stub=(0, -100)); L((3300, 7500), "RLY_SPK", 3, stub=(0, 100))
    for x, y, t in ((800, 1300, "Przelacznik glosnikow Marantz / Lampa - plytka w obudowie trafo (pod lewym TG)"),
                    (800, 1420, "Cewki bez pradu: kolumny <- Marantz (NC). Lampa gotowa (ESP32, DRV7): kolumny <- Lampa (NO)."),
                    (800, 1540, "Przelaczane oba bieguny - wyjscia Marantza i Lampy nigdy nie sa ze soba polaczone."),
                    (800, 1660, "ESP32 przelacza tylko przy MUTE; R127 (100R 2W) zostaje na wtornym kazdego TG."),
                    (800, 7900, "J7: z plytki sterowania J13 (+12 V, RLY_SPK)")):
        S.note(x, y, t, 60)
    S.autolabel()
    return S


def build_ul():
    b = ul()
    S = WiredSch(b, ("A4", 11693, 8268))
    P, W, L = S.put, S.w, S.lab
    P("J1", "CONNR_3", 1500, 2500); P("K1", None, 4000, 2600)
    P("J2", "CONNR_3", 1500, 4600); P("K2", None, 4000, 4700)
    P("J3", "CONNR_2", 1500, 6400); P("D1", "D_V", 3000, 6400); P("D2", "D_V", 3600, 6400)
    W(("D1", 1), (3000, 6100), (3600, 6100), ("D2", 1)); W(("D1", 2), (3000, 6700), (3600, 6700), ("D2", 2))
    L((3300, 6100), "+12V", 1, stub=(0, -100)); L((3300, 6700), "RLY_UL", 3, stub=(0, 100))
    for x, y, t in ((800, 1300, "Przelacznik UL / trioda - jedna plytka na kanal (2 x KT88)"),
                    (800, 1420, "Cewka bez zasilania: G2 <- odczep UL (normalnie). Cewka zasilona: G2 <- anoda (trioda)."),
                    (800, 1540, "PRZELACZAC TYLKO PRZY WYLACZONYM B+ (ESP32: K3/K4 off, czekaj na B+ < 30 V, przelacz, start)."),
                    (800, 1660, "Rezystor siatki ekranowej R123/R124 (270R 2W) zostaje przy nozce 4 podstawki KT88."),
                    (5200, 2300, "G2RL-2: oba styki rownolegle"), (800, 7300, "J3: z plytki sterowania J11 (+12 V, RLY_UL)")):
        S.note(x, y, t, 60)
    S.autolabel()
    return S


if __name__ == "__main__":
    for f in (build_siec, build_hv, build_ctl, build_ul, build_glosniki):
        S = f()
        e = S.verify()
        print(f.__name__, "\n".join(e) if e else "NO ERRORS")
