sieraczynski-lab/Soloist-KT88/(commit log)

2026-11-07 Soloist 88: projekt, płytki, obudowa i dokumentacja
    Pliki KiCad/EasyEDA (v0.23), BOM-y LCSC i SMD JLCPCB, obudowa STEP/DXF (v0.4),
    strona projektu, generatory w Pythonie oraz dokumentacja w docs/.
    Claude-Session: https://claude.ai/code/session_017dbtvjJDjWBtMA73Ywvh5S
    [AL_bok_lewy.dxf, AL_bok_prawy.dxf, AL_dno_400x460x3.dxf, AL_ekran_sterowania.dxf, AL_pokrywa_gorna.dxf, AL_przod_wewn.dxf, AL_trafo_dach.dxf, AL_trafo_przegroda_L.dxf]
2026-11-07 Selektor wejść z przekaźnikową drabinką głośności (v0.5)
    Nowa płytka `selektor`: 4 wejścia stereo, drabinka 0-63 dB co 1 dB
    na Omron G6K-2F-Y DC12, mute fail-safe, sterowanie I2C (MCP23017
    0x20 + 2x ULN2803G-S18-R), zasilanie tylko 12 V.
    - hardware/selektor: projekt KiCad 8 (schemat, rozmieszczenie
    96x74 mm, bez ścieżek), eksport KiCad 5.1 do EasyEDA Pro, BOM-y
    JLCPCB i LCSC
    - src/selektor: generator i weryfikacja (netlista schemat vs PCB,
    kolizje, symulacja drabinki dla 64 kodów)
    - docs/11-selektor.md: decyzje projektowe, drabinka, sterowanie,
    integracja z płytką sterowania, masy i ekranowanie, poziomy
    względem EF86, firmware, zakupy, montaż, otwarte punkty
    - REA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
    [BOM.csv, JLCPCB_BOM.csv, LCSC_zamowienie.csv, tube_selector.kicad_pcb, tube_selector.kicad_sch, tube_selector.sch]
